eSpark-Backup/griffin-radarsystem-hw/Design Files/MainBoard_2.0/Renderings/2D_C-View.PNG

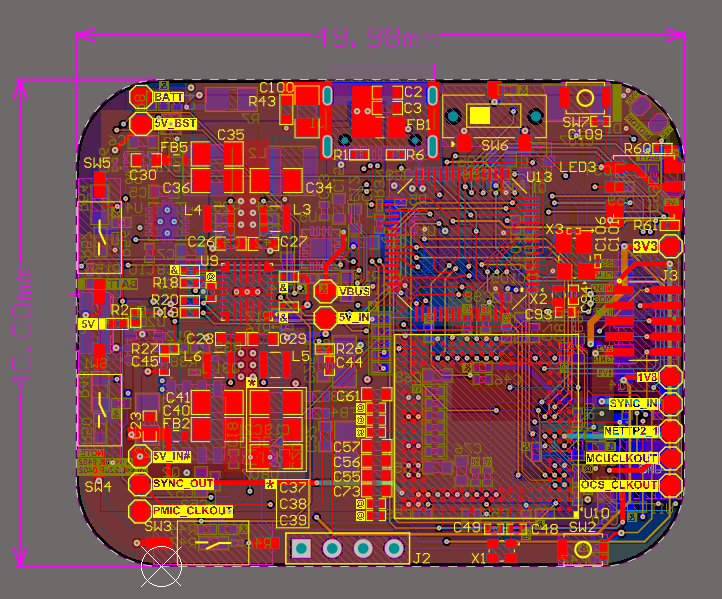
Design Files/MainBoard_2.0/Renderings/2D_C-View.PNG
