eSpark-Backup/griffin-radarsystem-hw/Design Files/MainBoard_2.0/Renderings/2D_Top-Layer.PNG

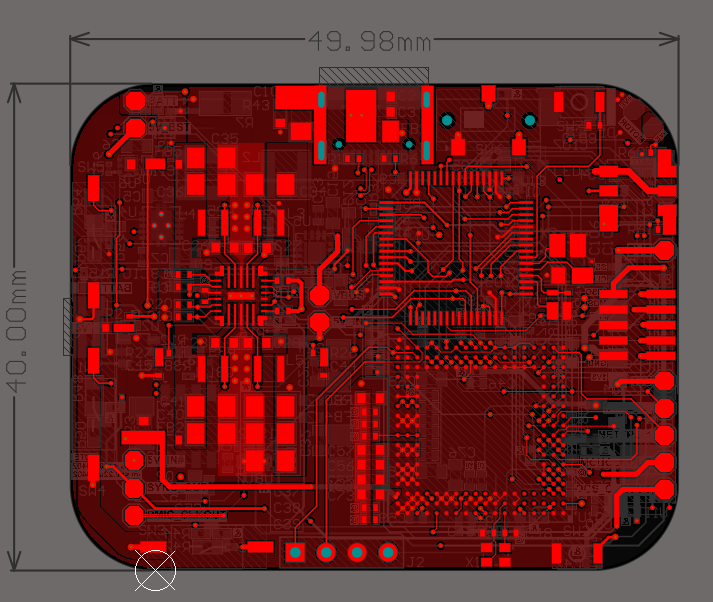
Design Files/MainBoard_2.0/Renderings/2D_Top-Layer.PNG
