eSpark-Backup/griffin-radarsystem-hw/Design Files/MainBoard_2.0/Renderings/3D_Top-View.PNG

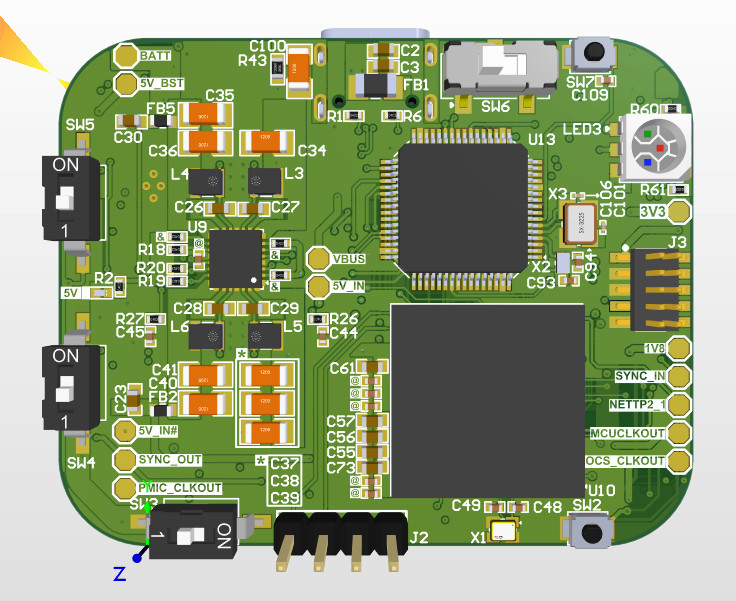
Design Files/MainBoard_2.0/Renderings/3D_Top-View.PNG
