eSpark-Backup/griffin-radarsystem-hw/Design Files/SecondaryBoard_2.0/Renderings/2D_Bottom_Layer.PNG

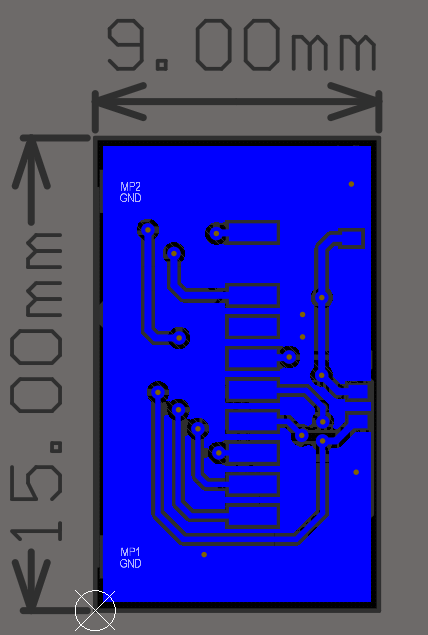
Design Files/SecondaryBoard_2.0/Renderings/2D_Bottom_Layer.PNG
