eSpark-Backup/griffin-radarsystem-hw/Design Files/MainBoard_2.0/BOM/Client-BOM-Main_Board_2.0.xlsx

# | Item Type | Designator | Description | Footprint | Manufacturer Part Number | Manufacturer | Value | Quantity | Remarks
1 | Capacitor | C1, C46, C47, C51, C53, C79, C80, C96, C97, C98, C99, C104, C105, C107, C109 | CAP CER 0.1UF 16V X7R 0402 | Cap-0402 | CC0402JRX7R7BB104 | Yageo | 0.1uF | 15
2 | Capacitor | C2, C3, C14, C23, C25, C26, C27, C28, C29, C30, C32, C52, C54, C57, C61, C65, C69, C73, C76, C90 | CAP CER 10UF 16V X5R 0603 | Cap-0603 | CC0603KRX5R7BB106 | Yageo | 10uF | 20
3 | Capacitor | C4, C11, C18, C19, C20, C21, C50, C58, C60, C102 | CAP CER 1UF 16V X5R 0402 | Cap-0402 | CC0402KRX5R7BB105 | Yageo | 1uF | 10
4 | Capacitor | C5, C7, C8, C9 | CAP CER 22UF 10V X5R 0603 | Cap-0603 | CC0603MRX5R6BB226 | Yageo | 22uF | 4
5 | Capacitor | C6, C12, C15, C17, C55, C56, C81, C87 | CAP CER 2.2UF 25V X5R 0603 | CAP-0603 | CC0603KRX5R8BB225 | Yageo | 2.2uF | 8
6 | Capacitor | C10, C103 | CAP CER 10000PF 25V X7R 0402 | Cap-0402 | CC0402KRX7R8BB103 | Yageo | 10nF | 2
7 | Capacitor | C13, C59 | CAP CER 0.047UF 50V X7R 0402 | Cap-0402 | CC0402KRX7R9BB473 | Yageo | 47nF | 2
8 | Capacitor | C16 | CAP CER 1000PF 25V X5R 0201 | CAP-0201 | CC0201KRX5R8BB102 | Yageo | 1nF | 1
9 | Capacitor | C22, C24, C31, C34, C35, C36, C37, C38, C39, C40, C41 | CAP CER 22UF 25V X5R 1206 | Cap-1206 | C3216X5R1E226M160AB | TDK | 22uF | 11
10 | Capacitor | C33, C62, C63, C64, C66, C67, C68, C70, C71, C72, C74, C75, C77, C78, C82, C83, C84, C85, C86, C88, C89, C91, C92 | CAP CER 0.22UF 25V X5R 0402 | Cap-0402 | CC0402KRX5R8BB224 | Yageo | 0.22uF | 23
11 | Capacitor | C42, C43, C44, C45 | CAP CER 390PF 50V C0G 0402 | Cap-0402 | CGA2B2C0G1H391J050BA | TDK | 390pF | 4
12 | Capacitor | C48, C49 | CAP CER 4.7PF 50V C0G/NPO 0402 | Cap-0402 | CC0402BRNPO9BN4R7 | Yageo | 4.7pF | 2
13 | Capacitor | C93, C94 | CAP CER 19PF 50V C0G/NP0 0402 | Cap-0402 | GJM1555C1H190GB01D | Murata | 19pF | 2
14 | Capacitor | C95 | CAP CER 4.7UF 16V X5R 0603 | Cap-0603 | CC0603KRX5R7BB475 | Yageo | 4.7uF | 1
15 | Capacitor | C100 | CAP CER 4700PF 1KV X7R 1206 | Cap-1206 | CC1206KKX7RCBB472 | Yageo | 4.7nF | 1
16 | Capacitor | C101, C106 | CAP CER 18PF 25V C0G/NP0 0201 | CAP-0201 | GJM0335C1E180GB01D | Murata Electronics | 18pF | 2
17 | Diode | D1 | 1A Single 50V 1.1V@1A SMA(DO-214AC) Diodes - General Purpose ROHS | SMA(DO-214AC) | 1N4001 | TWGMC | 1N4001 | 1
18 | Ferrite Bead | FB1 | FERRITE BEAD 120 OHM 1206 1LN | IND-1206 | BLM31PG121SN1L | Murata | 100MHz | 1
19 | Ferrite Bead | FB2, FB3, FB4, FB5 | FERRITE BEAD 100 OHM 0603 1LN | IND-0603 (1608 Metric) | BLM18SP101SZ1D | Murata | 100MHz | 4
20 | Connector | J1 | 5A 1 16P Female Type-C SMD USB Connectors ROHS | TYPE-C-31-M-12_ | TYPE-C-31-M-12 | Korean Hroparts Elec | TYPE-C-31-M-12 | 1
21 | Header | J2 | Straight 2.54mm Black Brass 1x4P Plugin,P=2.54mm Pin Headers ROHS | HDR1X4_ | B-2100S04P-A110 | Ckmtw | - | 1
22 | Header | J3 | CONN HEADER SMD 10POS 1.27MM | Custom | 20021121-00010C4LF | Amphenol ICC (FCI) | - | 1
23 | JST Connector | J4 | CONN HEADER SMD R/A 10POS 1MM | SM10B-SRSS-TB(LF)(SN) | SM10B-SRSS-TB(LF)(SN) | JST | - | 1
24 | Inductor | L1, L2 | FIXED IND 1UH 5.8A 26 MOHM SMD | Custom | WPN4020H1R0MT | Sunlord | 1uH | 2
25 | Inductor | L3, L4, L5, L6 | FIXED IND 470NH 4A 0.027OHM SMD | IND-1008 (2520 Metric) | DFE252012PD-R47M=P2 | Murata | 470nH | 4
26 | LED | LED1 | LED GREEN CLEAR CHIP SMD | LED-0402 | XZVG68W-2 | SunLED | - | 1
27 | LED | LED2 | LED RED CLEAR CHIP SMD | LED-0402 | XZMDK68W-2 | SunLED | - | 1
28 | RGB LED | LED3 | 20mA White Diffused -40℃~+85℃ RGB SMD5050 Light Emitting Diodes (LED) ROHS | SMD5050 | MHP5050RGBDT | MEIHUA | - | 1
29 | Mosfet | Q1 | TRANS NPN 40V 0.6A SMD SOT23-3 | SOT-23 | MMBT2222A-7-F | Diodes | - | 1
30 | MOSFET | Q2 | MOSFET P-CH 12V 16A 8SO | SOP-8 | IRF7410TRPBF | Infineon | - | 1
31 | Mosfet | Q3 | 40V 100mW 100@10mA,1V 200mA 300MHz 300mV@50mA,5mA NPN -55℃~+150℃@(Tj) SOT-723 Bipolar Transistors - BJT ROHS | SOT-723 | MMBT3904M | TECH PUBLIC | - | 1
32 | Resistor | R1, R6, R8 | RES 5.1K OHM 1% 1/16W 0402 | Res-0402 | RC0402FR-075K1L | Yageo | 5.1K | 3
33 | Resistor | R2 | RES SMD 510 OHM 1% 1/16W 0402 | Res-0402 | RT0402FRE07510RL | Yageo | 510R | 1
34 | Resistor | R3, R5, R11, R15, R16, R38 | RES 1K OHM 1% 1/20W 0201 | Res-0201 | RC0201FR-071KL | Yageo | 1K | 6
35 | Resistor | R4, R9, R10, R14, R21, R22, R23, R28, R29, R30, R31, R32, R33, R34, R35, R36, R37, R40, R41, R42, R45, R49, R55, R58 | RES 10K OHM 1% 1/16W 0402 | Res-0402 | RC0402FR-0710KL | Yageo | 10K | 24
36 | Resistors | R7 | RES 0.01 OHM 1% 1W 1206 | Res-1206 | PA1206FRE470R01Z | Yageo | 10mR | 1
37 | Resistor | R12, R18, R19, R20, R39 | RES 4.7K OHM 1% 1/16W 0402 | Res-0402 | RC0402FR-074K7L | Yageo | 4.7K | 5
38 | Resistor | R13 | RES 20K OHM 1% 1/10W 0603 | Res-0603 | RC0603FR-0720KL | Yageo | 20K | 1
39 | Resistor | R17 | RES 1.96K OHM 1% 1/10W 0603 | Res-0603 | RC0603FR-071K96L | Yageo | 1.96K | 1
40 | Resistors | R24, R25, R26, R27 | RES SMD 3.83 OHM 1% 1/16W 0402 | Res-0402 | CRCW04023R83FKED | Vishay Dale | 3.83R | 4
41 | Resistor | R43 | RES SMD 1M OHM 1% 1/10W 0603 | Res-0603 | RC0603FR-071ML | Yageo | 1M | 1
42 | Resistors | R44 | RES 0 OHM JUMPER 1/16W 0402 | Res-0402 | RC0402FR-070RL | Yageo | 0R | 1
43 | Resistor | R46, R56 | 50mW Thick Film Resistors ±1% 7.87kΩ 0201 Chip Resistor - Surface Mount ROHS | Res-0201 | 0201WMF7871TEE | UNI-ROYAL(Uniroyal Elec) | 7.87k | 2
44 | Resistor | R47, R50, R57 | 82kΩ 0603 Chip Resistor - Surface Mount ROHS | Res-0603 | 0603WAD8202T5E | UNI-ROYAL | 82K | 3
45 | Resistor | R48, R54 | RES SMD 750 OHM 0.1% 1/8W 0805 | RES-0805 | RT0805BRD07750RL | Yageo | 750R | 2
46 | Resistor | R59, R61 | Res 80.6 Ohm 1% 1/16W 0402 | Res-0402 | RN73H1ETTP80R6F50 | KOA Speer | 80.6R | 2
47 | Resistor | R60 | RES 280 OHM 0.5% 1/16W 0402 | Res-0402 | RN73H1ETTP2800D50 | KOA Speer | 280R | 1
48 | Tactile Switch | SW1 | SWITCH TACTILE SPST-NO 0.05A 12V | Custom | EVQ-P7A01P | Panasonic | - | 1
49 | Switch | SW2, SW7 | SWITCH TACTILE SPST-NO 0.05A 12V | Custom | B3U-1000P | Omron | - | 2
50 | Switch | SW3, SW4, SW5 | SPST Black Flat dial, raised type 2.54mm 1 SMD,2.5x6mm DIP Switches ROHS | Custom | DSIC01LSGET | DongGuan | - | 3
51 | Slide Switche | SW6 | SWITCH SLIDE SPDT 200MA 12V | Custom | CL-SB-12B-02T | Nidec Copal | - | 1
52 | IC | U1 | 1.6-V TO 5.5-V, 20-M, 4-A LOW IQ | SOT-583 | TPS2117DRLR | Texas Instruments | - | 1
53 | IC | U2 | IC CNTRLR ON/OFF W/DEB TSOT23-6 | TSOT-23-6 | MAX16054AZT+T | Maxim | - | 1
54 | IC | U3 | IC FUEL GAUGE LI-ION 1CL 9DSBGA | DSBGA-9 (1.651x1.61) | BQ27426YZFR | Texas Instruments | - | 1
55 | IC | U4 | IC REG BOOST 5V 5A 10VSON | 10-VSON (3x3) | TPS61232DRCR | Texas Instruments | - | 1
56 | IC | U5 | IC BATT CHG LI-ION 1CELL 16WQFN | 16-QFN (3x3). | BQ25302RTER | Texas Instruments | - | 1
57 | IC | U6 | Active Low 1 VSOF-5 Monitors & Reset Circuits ROHS | 5-VSOF | BD4830FVE-TR | Rohm | - | 1
58 | IC | U7 | IC REG LINEAR 3.3V 700MA 4XDFN | 4-UDFN (1.0x1.0) | NCP167BMX330TBG | ON Semiconductor | - | 1
59 | IC | U8 | IC REG LINEAR 1.8V 450MA 4XDFN | 4-UDFN (1.0x1.0) | NCP161BMX180TBG | ON Semiconductor | - | 1
60 | IC | U9 | IC REG BUCK ADJ QUAD 26VQFN | 26-VQFN-HR (4.5x4) | LP87524JRNFRQ1 | Texas Instruments | - | 1
61 | IC | U10 | RF IC Transceiver General Purpose 76GHz ~ 81GHz SPI Interface 180-FCBGA (15x15) | 180-FCBGA (15x15) | AWR1843ARBGALPQ1 | Texas Instruments | - | 1
62 | IC | U11 | IC FLASH 16MBIT SPI/QUAD 8WSON | 8-WSON 6x5-mm | MX25V1635FZNQ03 | Macronix | - | 1
63 | IC | U13 | IC MCU 32BIT 256KB FLASH 64LQFP | 64-LQFP (10x10) | STM32L433RCT6 | STMicroelectronics | - | 1
64 | Crystals | X1 | Crystal 40.0000MHZ 8PF SMD | SMD2016-4P | FW4000044Q | Diodes | 40 MHz | 1
65 | Crystal | X2 | CRYSTAL 32.7680KHZ 12.5PF SMD | Custom | ECS-.327-12.5-16-TR | ECS International | 32.768kHz | 1
66 | Crystal | X3 | CRYSTAL 8.0000MHZ 12PF SMD | SMD3225-4P | ECS-80-12-33-JGN-TR | ECS International | 8.0000MHZ | 1
67 | Peripheral | - | JUMPER 10SR-3S - 10SR-3S 4" | Custom | A10SR10SR30K102A | JST Sales America Inc. | - | 1
68 | Peripheral | - | SEGGER 8.08.91 J-Link EDU Mini | Custom | J-Link EDU Mini (8.08.91) | Segger | - | 1
69 | Peripheral | - | CP2102 USB UART Board (Type C), USB To TTL (UART) Communication Module, USB-C Connector | Custom | CP2102 | Waveshare | - | 1
70 | Peripheral | - | 3.7V Lithium polymer 8000mAh 7565121 Soft package battery For Power Bank Bluetooth Speakers Tablet DVD battery | - | Battery | - | - | 1 | Battery (https://vi.aliexpress.com/item/1005004274987553.html?gatewayAdapt=glo2vnm)
