eSpark-Backup/griffin-radarsystem-hw/Design Files/SecondaryBoard_2.0/BOM/Client_BOM_SecondaryBoard_2.0.xlsx

# | Item Type | Designator | Description | Footprint | Manufacturer Part Number | Manufacturer | Value | Quantity | Remarks
1 | Capacitor | C1, C2, C3, C6 | CAP CER 1UF 10V X5R 0402 | Cap-0402 | CC0402KRX5R6BB105 | Yageo | 1uF | 4
2 | Capacitor | C4, C5 | 50V 8pF C0G 0402 Multilayer Ceramic Capacitors MLCC - SMD/SMT ROHS | Cap-0402 | 0402CG8R0C500NT | FH (Guangdong Fenghua Advanced Tech) | 8pF | 2
3 | Ferrite Bead | FB1, FB2 | FERRITE BEAD 120 OHM 0402 1LN | IND-0402 | BLM15PD121SN1D | Murata | - | 2
4 | JST Connector | J1 | CONN HEADER SMD R/A 10POS 1MM | SM10B-SRSS-TB(LF)(SN) | SM10B-SRSS-TB(LF)(SN) | JST | - | 1
5 | IC | U1 | RADAR SENSOR SYSTEM-IN-PACKAGE B | 50-FCCSP (5.2x5.5) | A121-001-T&R | Acconeer | - | 1
6 | Crystal | X1 | CRYSTAL 24.0000MHZ 8PF SMD | SMD2520-4P | ECS-240-8-36-RWN-TR3 | ECS Inc. | - | 1
