eSpark-Backup/griffin-radarsystem-hw/Design Files/MainBoard_2.0/Supporting Files/PCB_Main_Board_v2.0.step

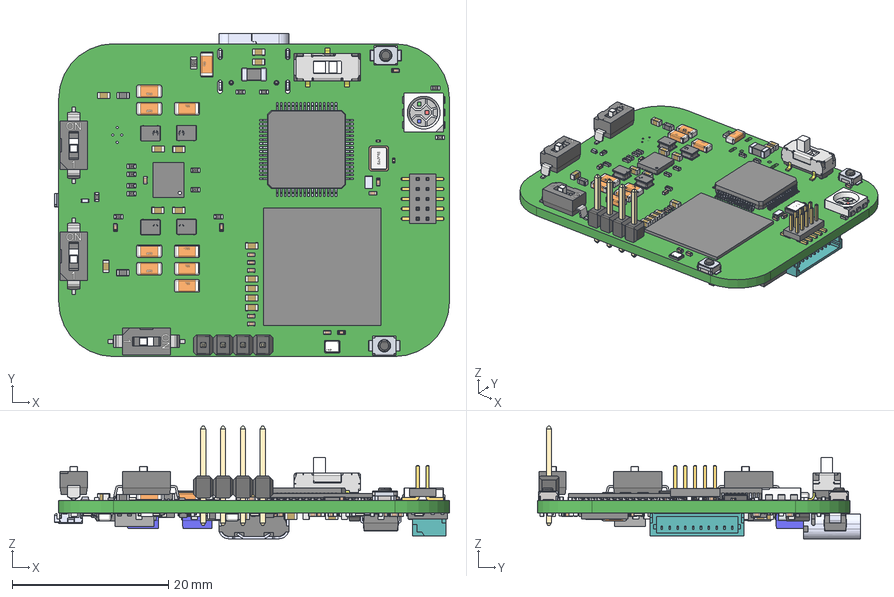
[picture p11: CAD file, 2024-05-08]
Design Files/MainBoard_2.0/Supporting Files/PCB_Main_Board_v2.0.step
50.5 x 41.3 x 14.4 mm
STM32F103RCT7
AWR1843ARBGALPQ1
SMA_(DO-214AC)
User_Library-Capacitor_0402 x 60
User_Library-RES_1005-0402 x 41
User_Library-RESC1608X05N x 6
User_Library-1206_SMD_Capacitor x 12
User_Library-0201(0603M)_Res x 8
VESM
TRANS_IRF7103TRPBF_INF
LED_SMD_5050_RGB
User_Library-CAPC1608X09 x 33
WSON8-6x5
LP87524JRNFRQ1
QFN-16_3X3_MNS
TPS63000DRCR
VLS252012HBX-100M x 4
User_Library-User_Library-Siward_SX3225
ECS-.327-12.5-16-TR--3DModel-STEP-1
Open_CASCADE_STEP_translator_6.8_10.1
Open_CASCADE_STEP_translator_6.8_10.2.1
lead x 5
BQ27426YZFR
User_Library-TSOT-23-6(S6)
User_Library-OMRON_B3U1000P x 2
12B-02_c
2Top_setting_s
SMD_DIP_SWITCH_1P x 3
User_Library-CR2012-0805 x 2
User_Library-CR3216-1206
CircuitWorks-SOT-23
User_Library-LED-0402 x 2
FilletPin1 x 2
FilletPin2 x 2
Conn_JST_SM10B-SRSS-TB_LF_SN_eec
User_Library-RM127_10pin_Header
holder
pin x 4
Lötende x 8
base x 4
BLM31PG121SN1L
User_Library-SMD_Ceramic_Capacitors_0201_(0603)_AB x 3
TYPE-C-31-M-12
EVQ-P7A01P--3DModel-STEP-269445
