eSpark-Backup/griffin-radarsystem-hw/Design Files/SecondaryBoard_2.0/Supporting Files/SecondaryBoard_2.0.step

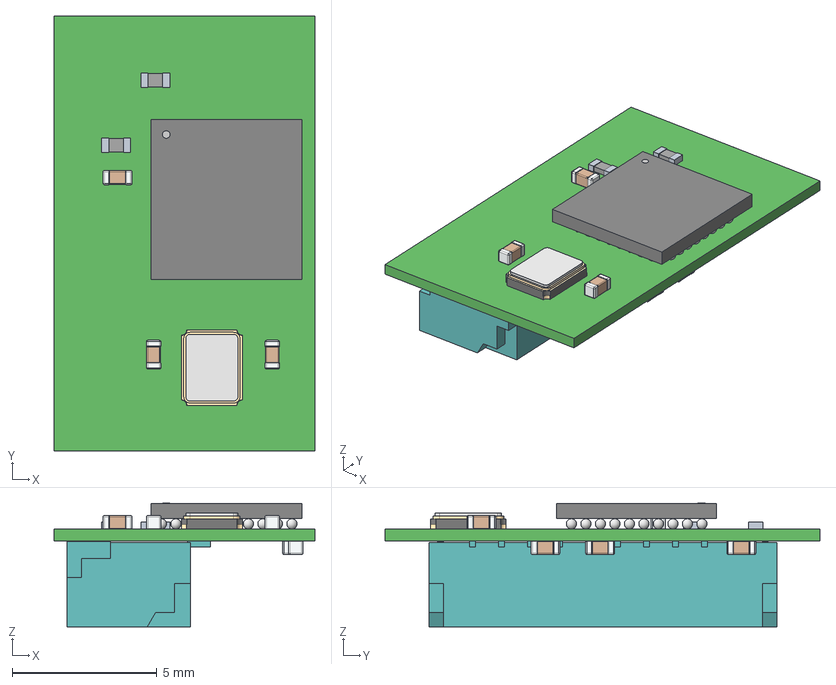
[picture p12: CAD file, 2024-05-08]
Design Files/SecondaryBoard_2.0/Supporting Files/SecondaryBoard_2.0.step
9.00 x 15.0 x 4.26 mm
User_Library-Capacitor_0402 x 6
User_Library-Crystal_NDK_NX2520SA_series
A111_ACC
Conn_JST_SM10B-SRSS-TB_LF_SN_eec
User_Library-d0402h025 x 2
