eSpark-Backup/griffin-radarsystem-hw/docs/Client-Files/Src Files - v1.0/60ghz radar 2nd pcb/2nd pcb.DXF

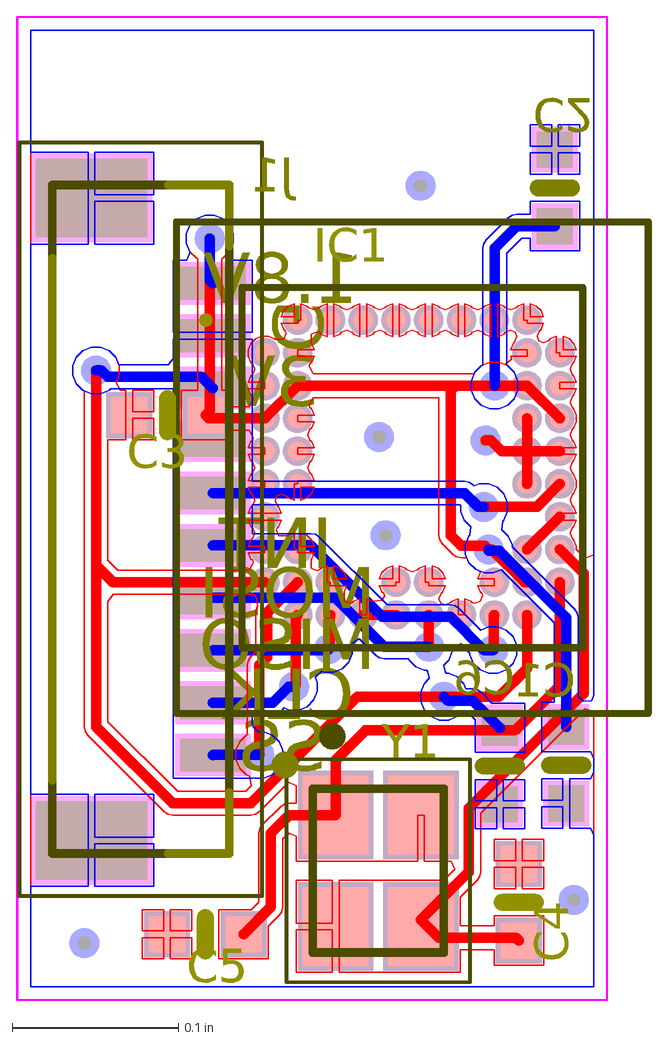
[picture p13: CAD file, 2024-05-08]
docs/Client-Files/Src Files - v1.0/60ghz radar 2nd pcb/2nd pcb.DXF
G
3V
1.8V
MISO
MOSI
INT
CLK
SS
Y1
J1
IC1
C3
C5
C4
C1
C6
C2
