eSpark-Backup/griffin-radarsystem-hw/(list of files, cad)

Other CAD files:
Design Files/MainBoard_2.0/Supporting Files/PCB_Main_Board_v2.0.DWG
Design Files/MainBoard_2.0/Supporting Files/PCB_Main_Board_v2.0.DXF
Design Files/SecondaryBoard_2.0/Supporting Files/SecondaryBoard_2.0.DWG
Design Files/SecondaryBoard_2.0/Supporting Files/SecondaryBoard_2.0.DXF
