eSpark-Backup/griffin-radarsystem-hw/Design Files/MainBoard_2.0/Schematic/Schematic_Main_Board_2.0.pdf

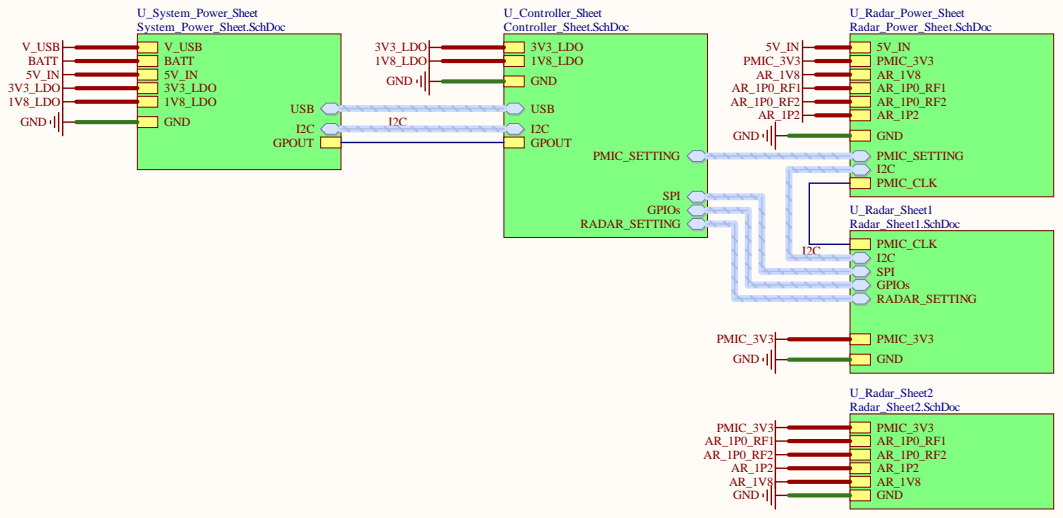
[picture p14: page 1]

Cannot open file
D:\eSpark-Consultants\eSpark-Hardware\Altium
Template\espark-consulting-group-800x300.jpg.
File does not exist.

Date: 5/8/2024 | Page Num: 1

Drawn By: Huzaifa Ali | Page Total:

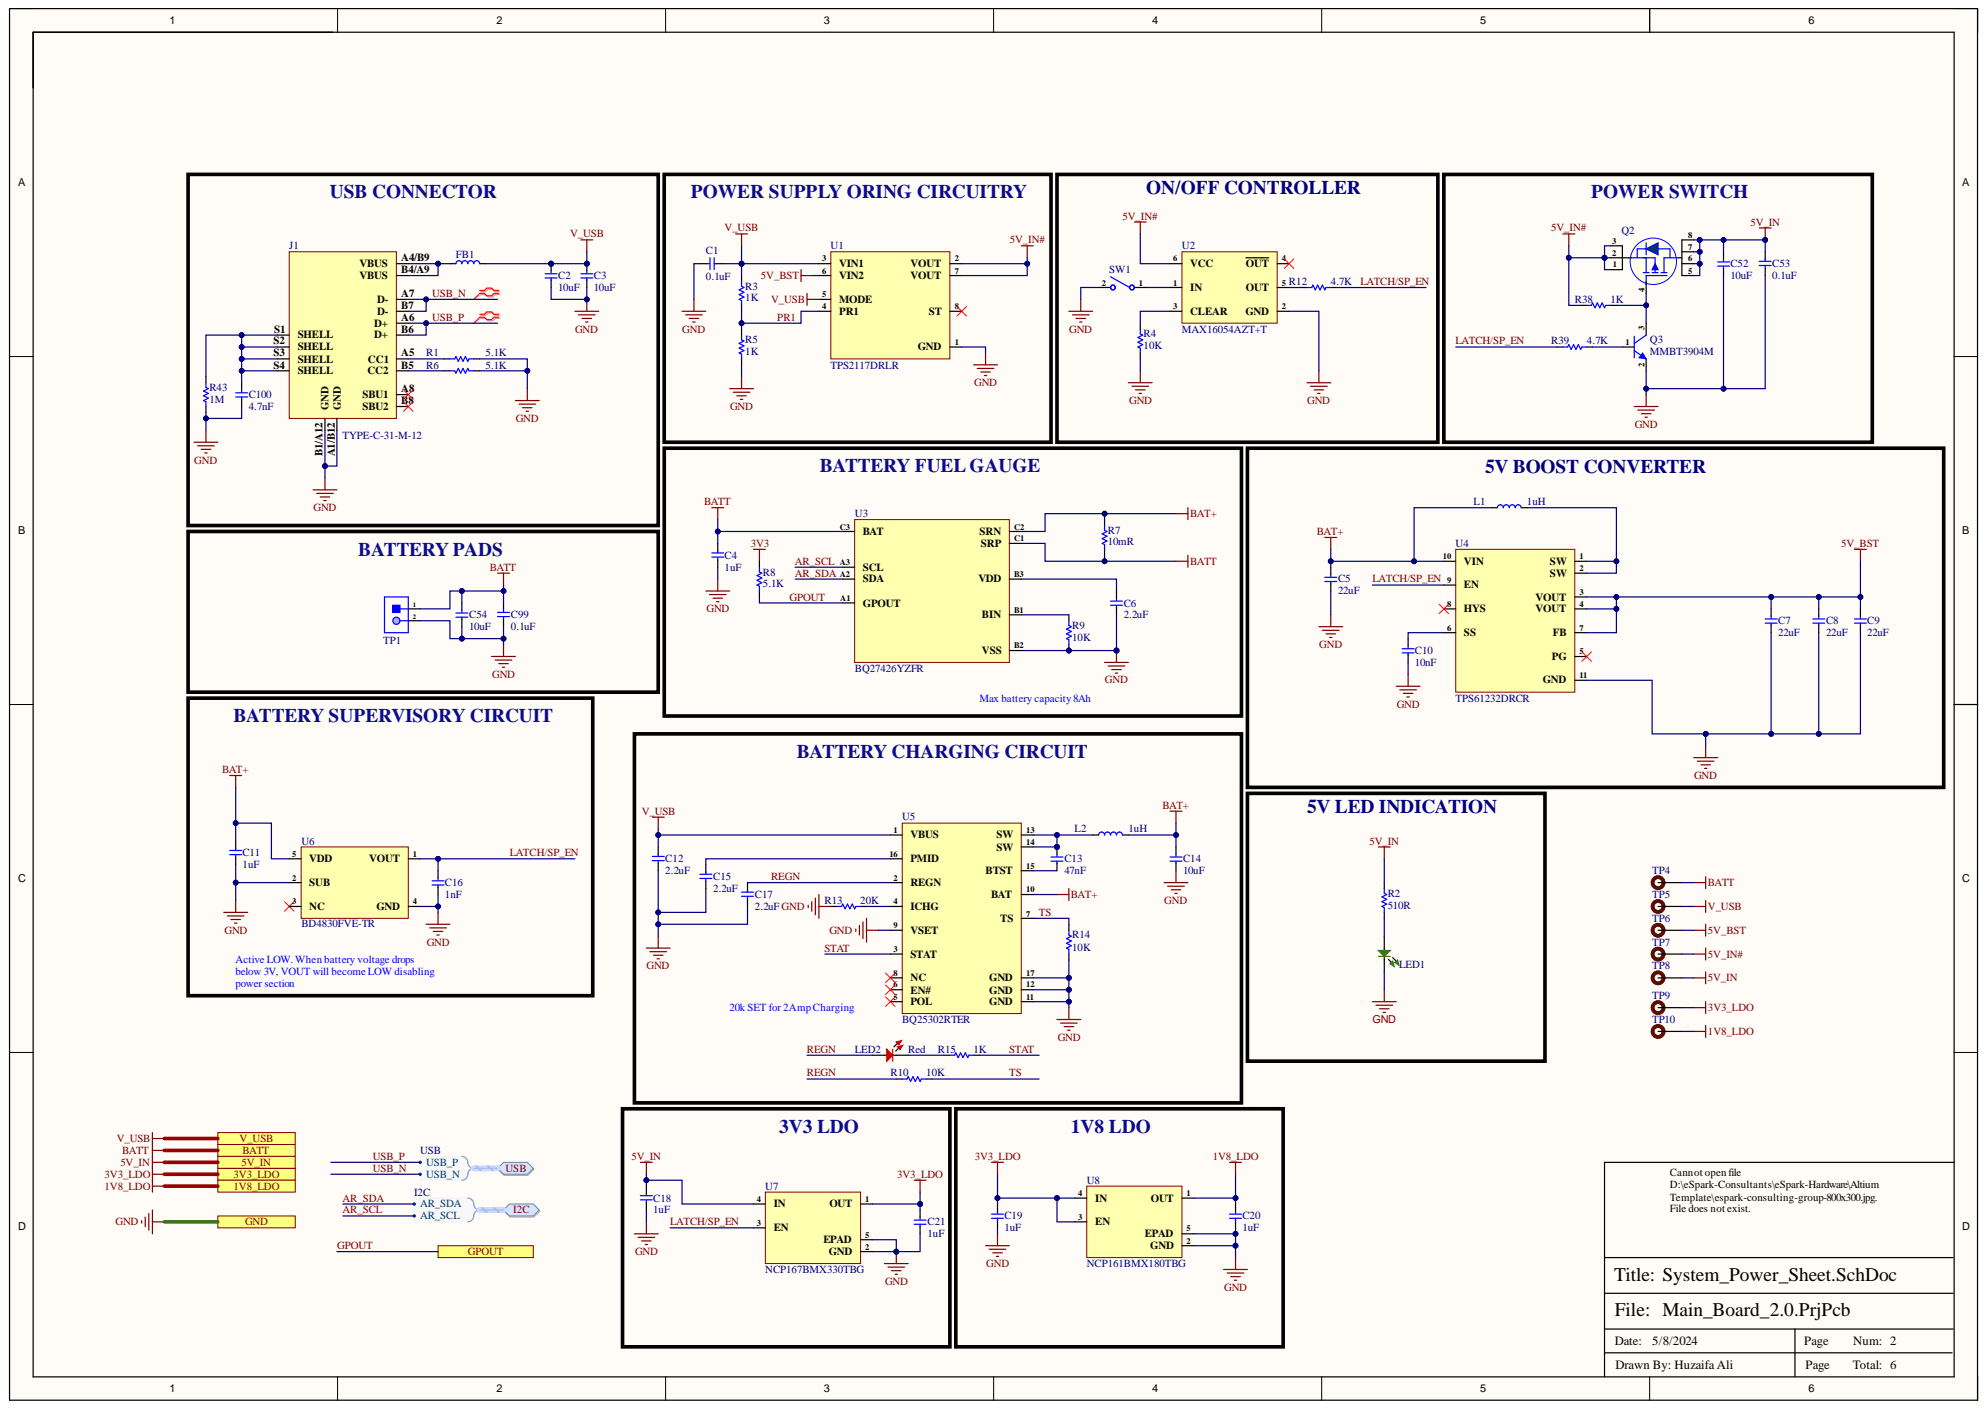
[picture p15: page 2]

Active LOW. When battery voltage drops
below 3V, VOUT will become LOW disabling
power section

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

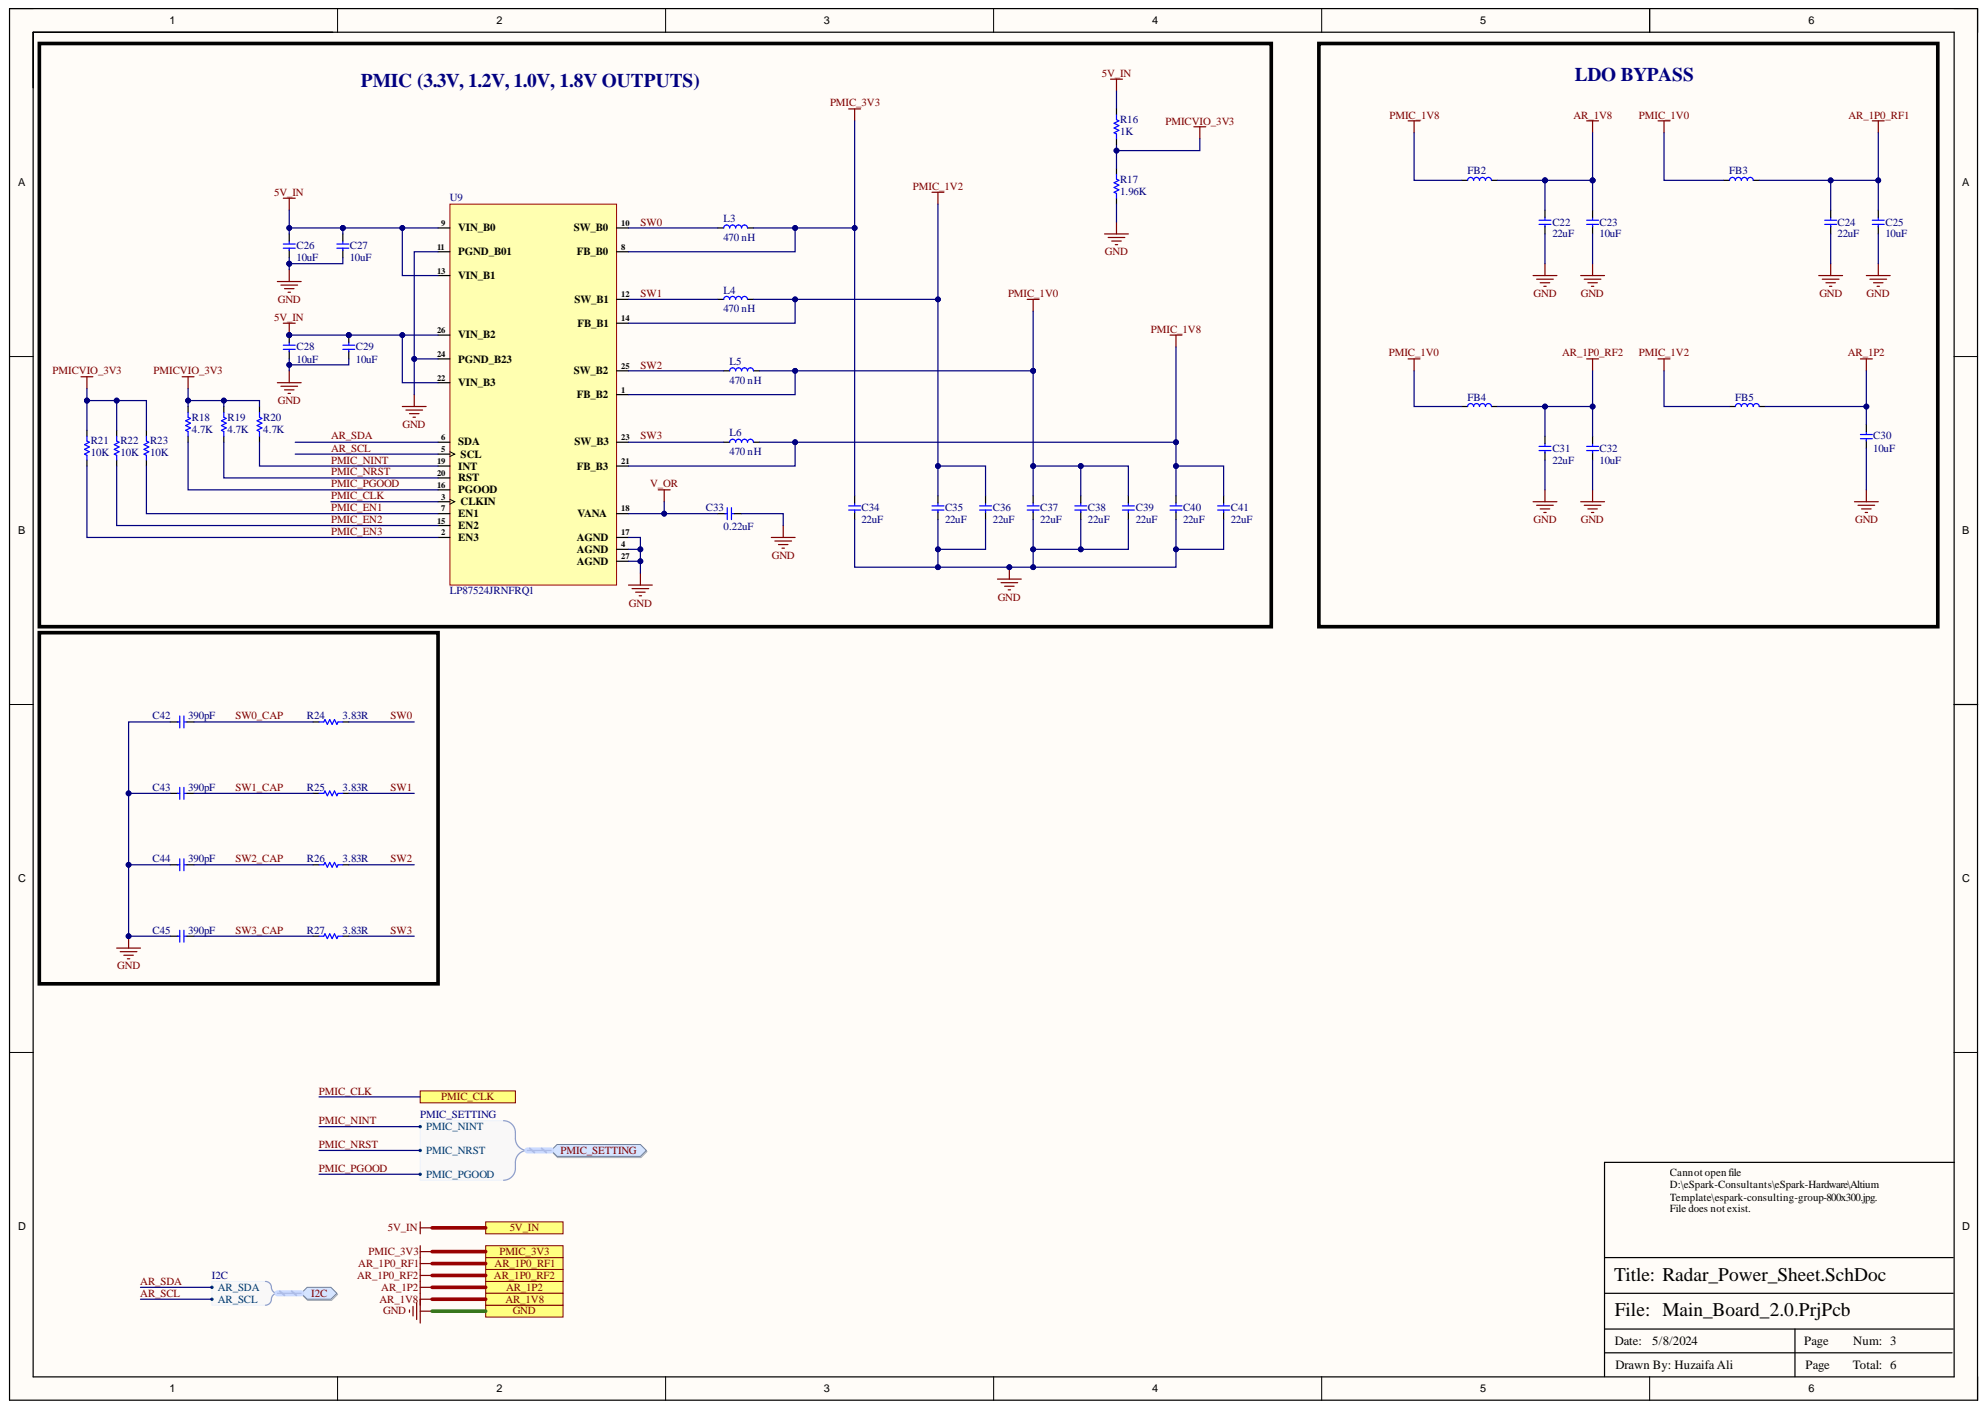
[picture p16: page 3]

L5 SW2
470 nH | GND

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

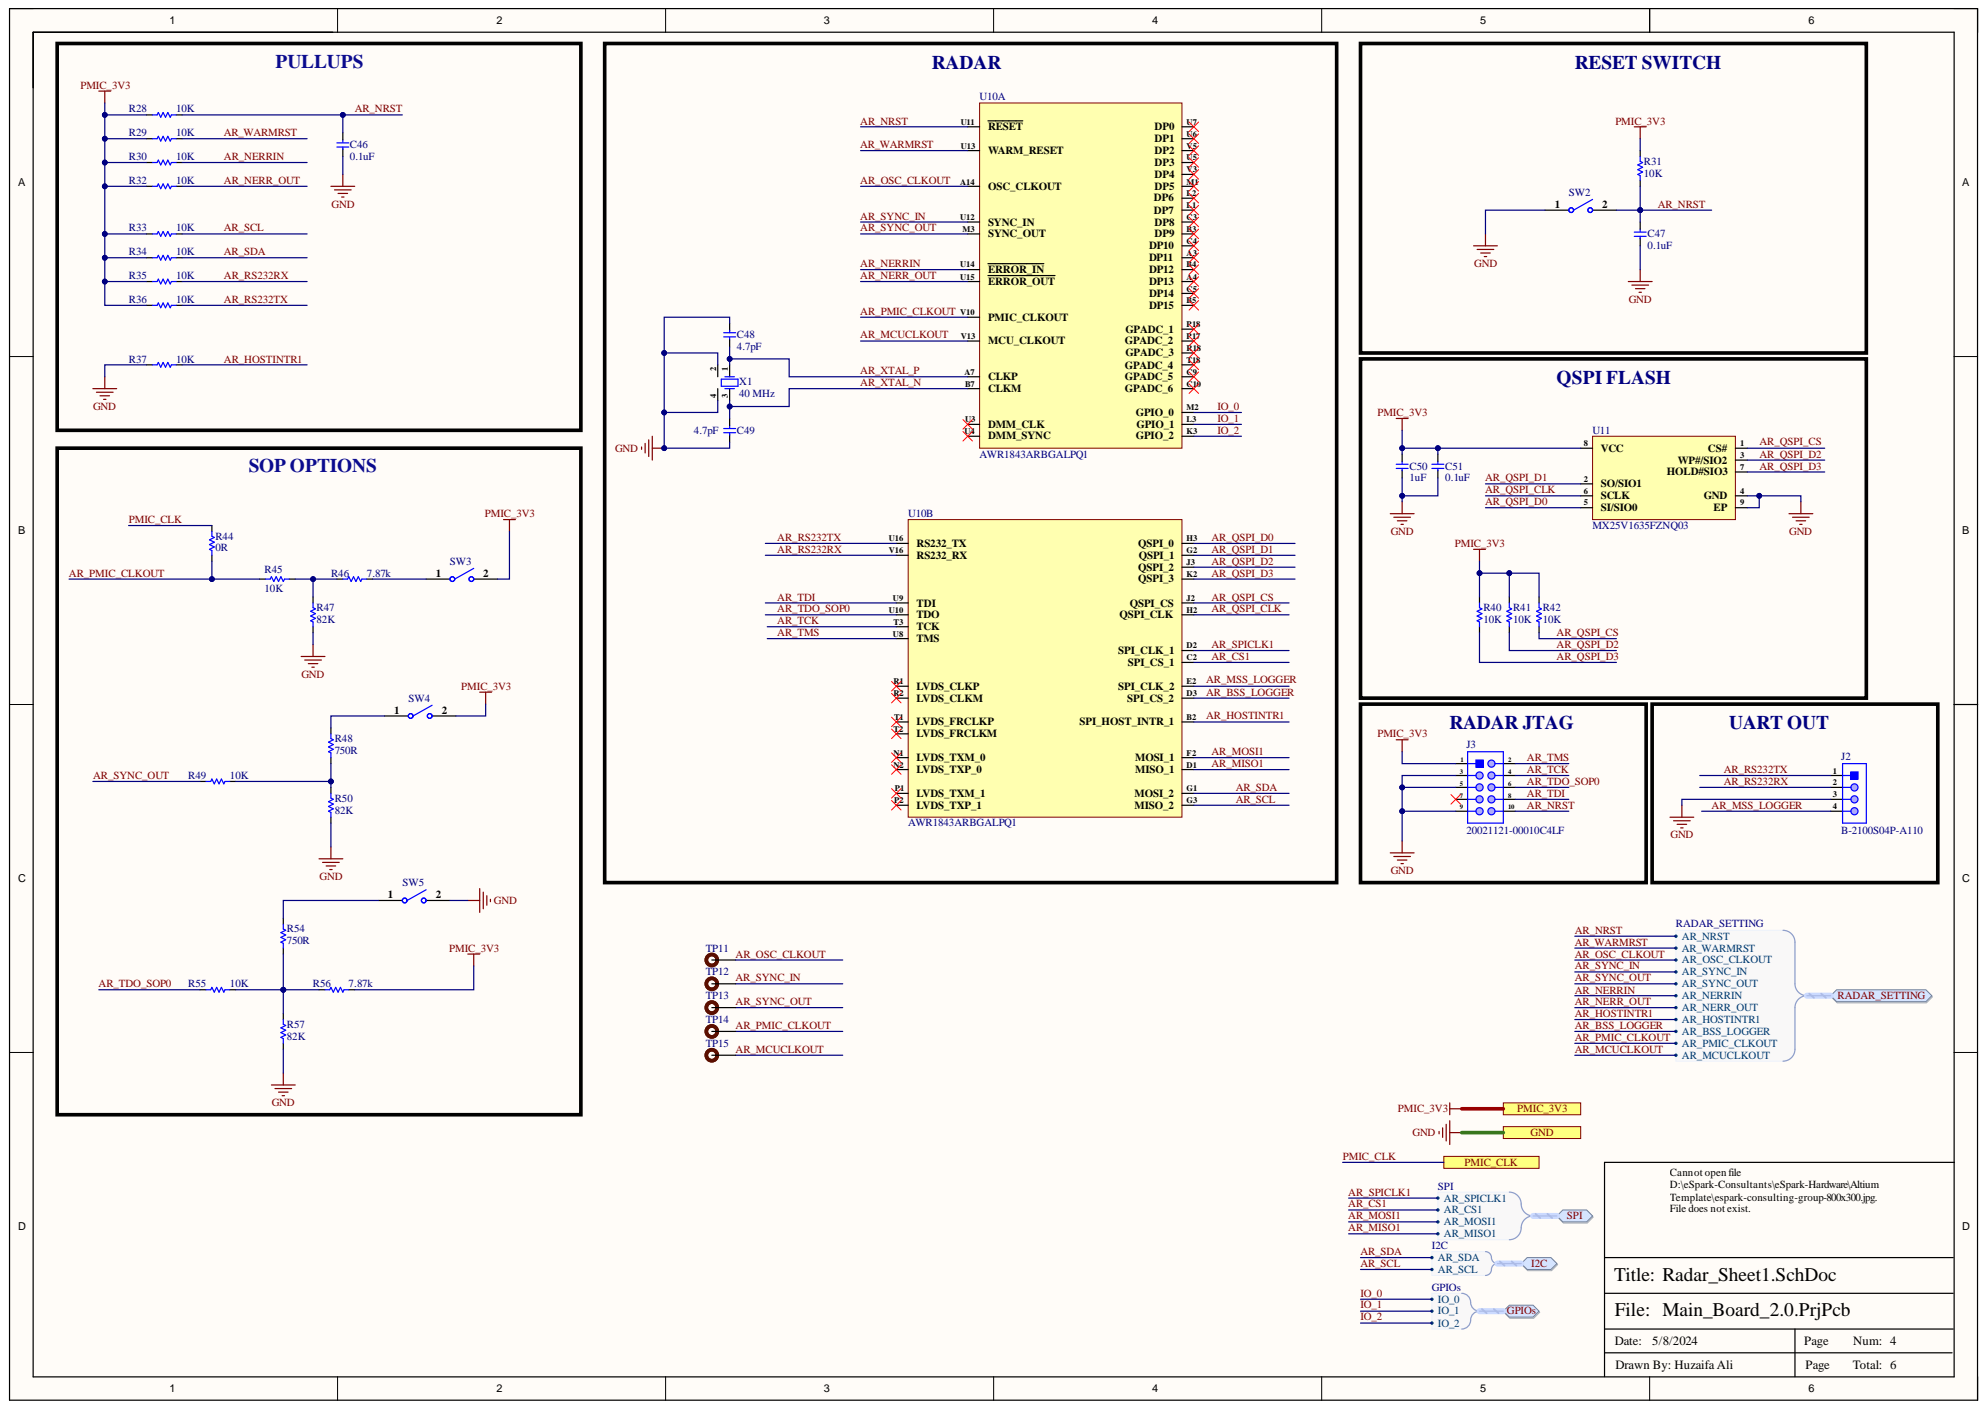
[picture p17: page 4]

AR_QSPI_CS

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

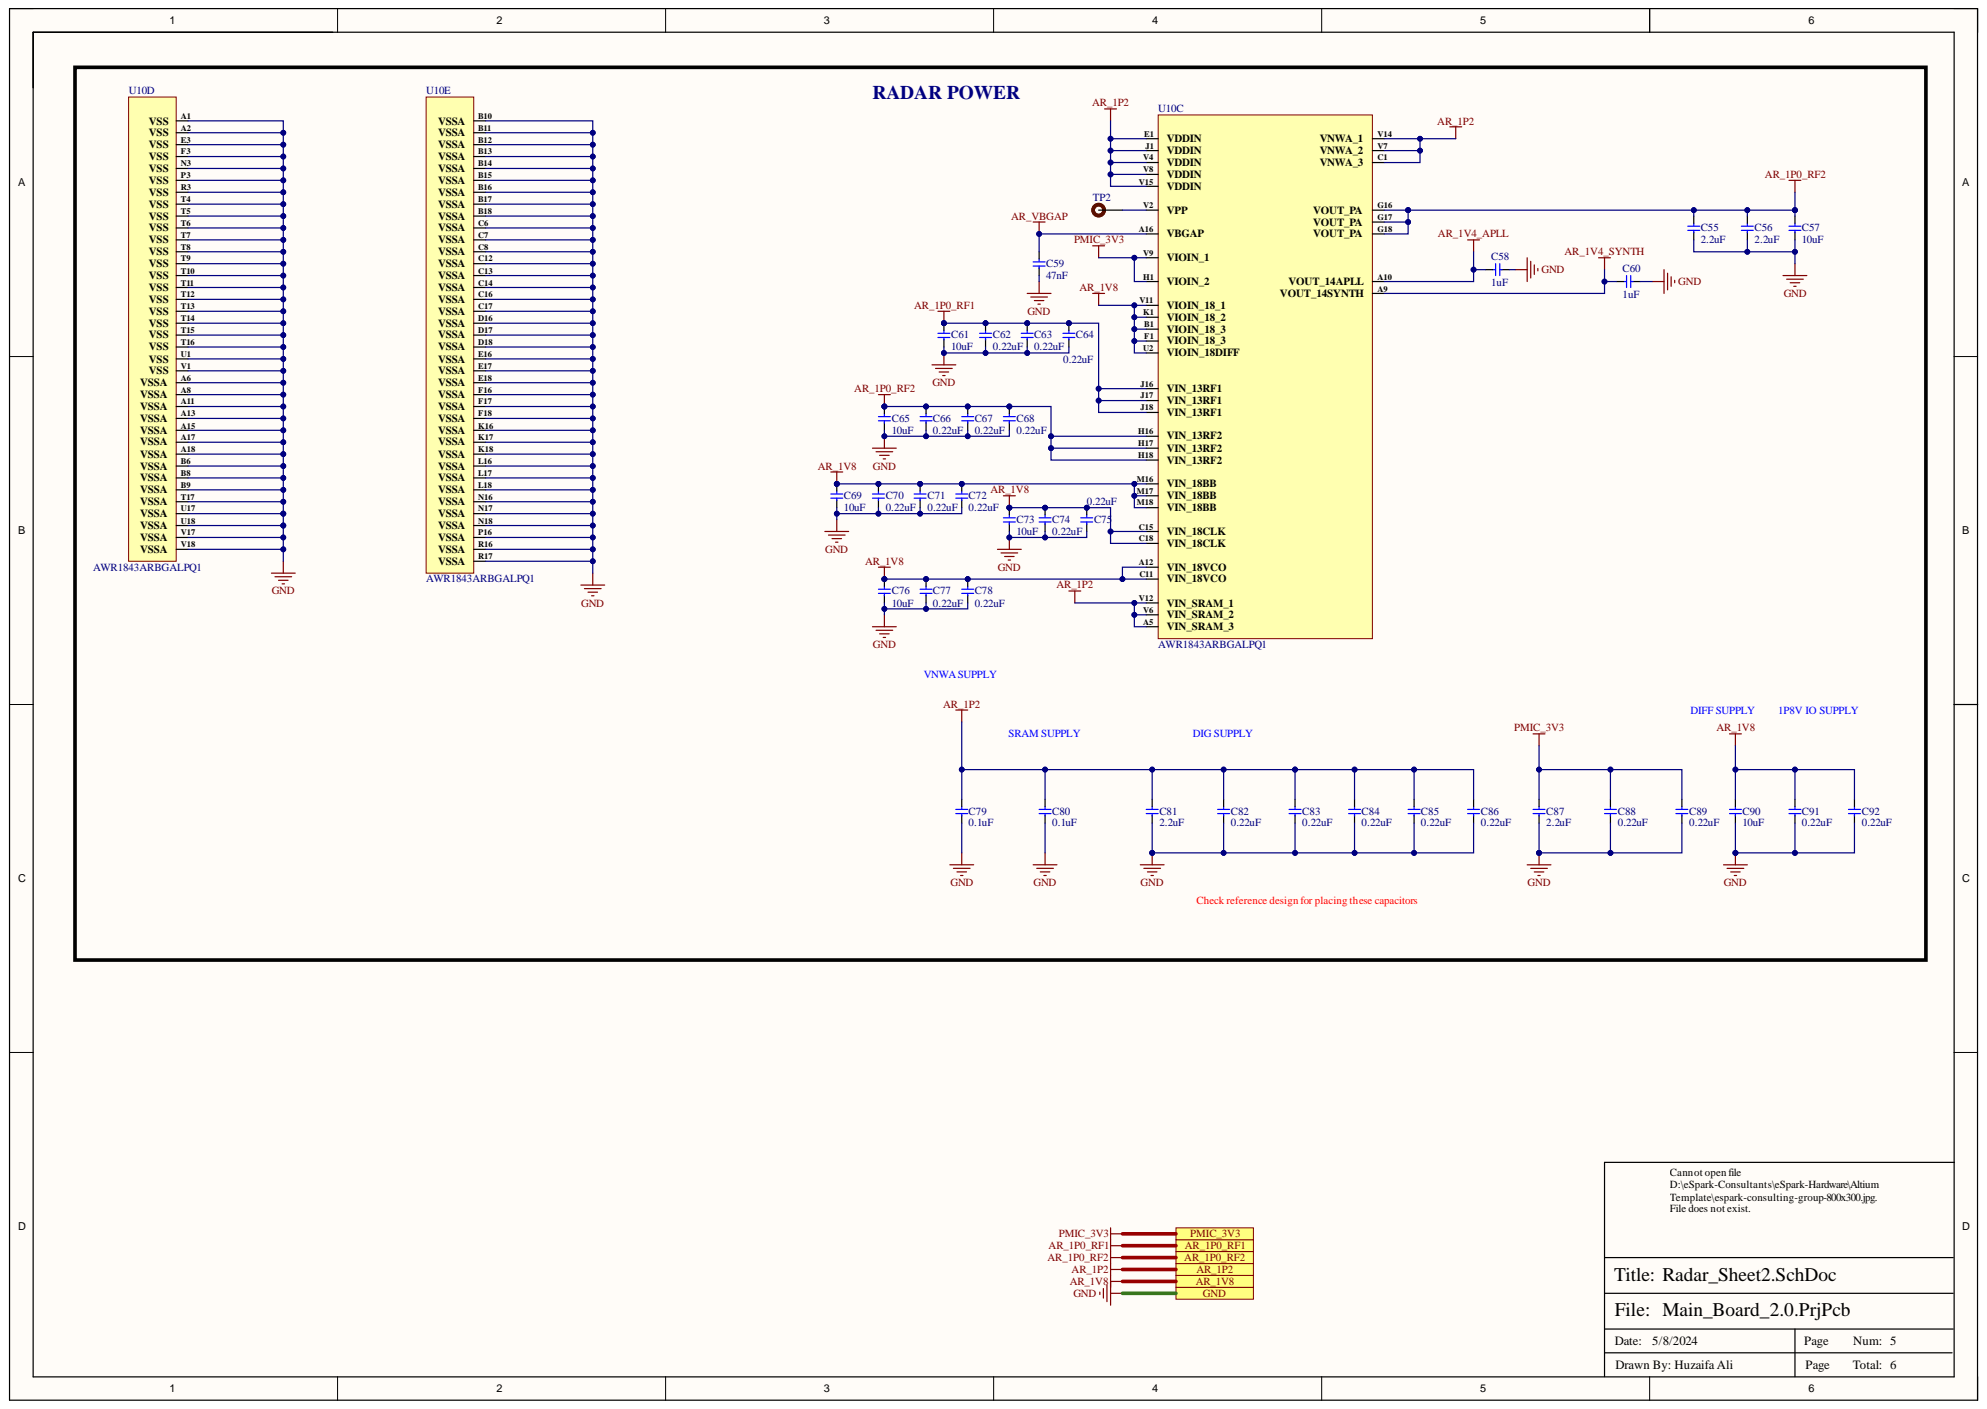
[picture p18: page 5]

C55 C56 AR_1V4_APLL

PMIC_3V3 | VIOIN_1 V9

Check reference design for placing these capacitors

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

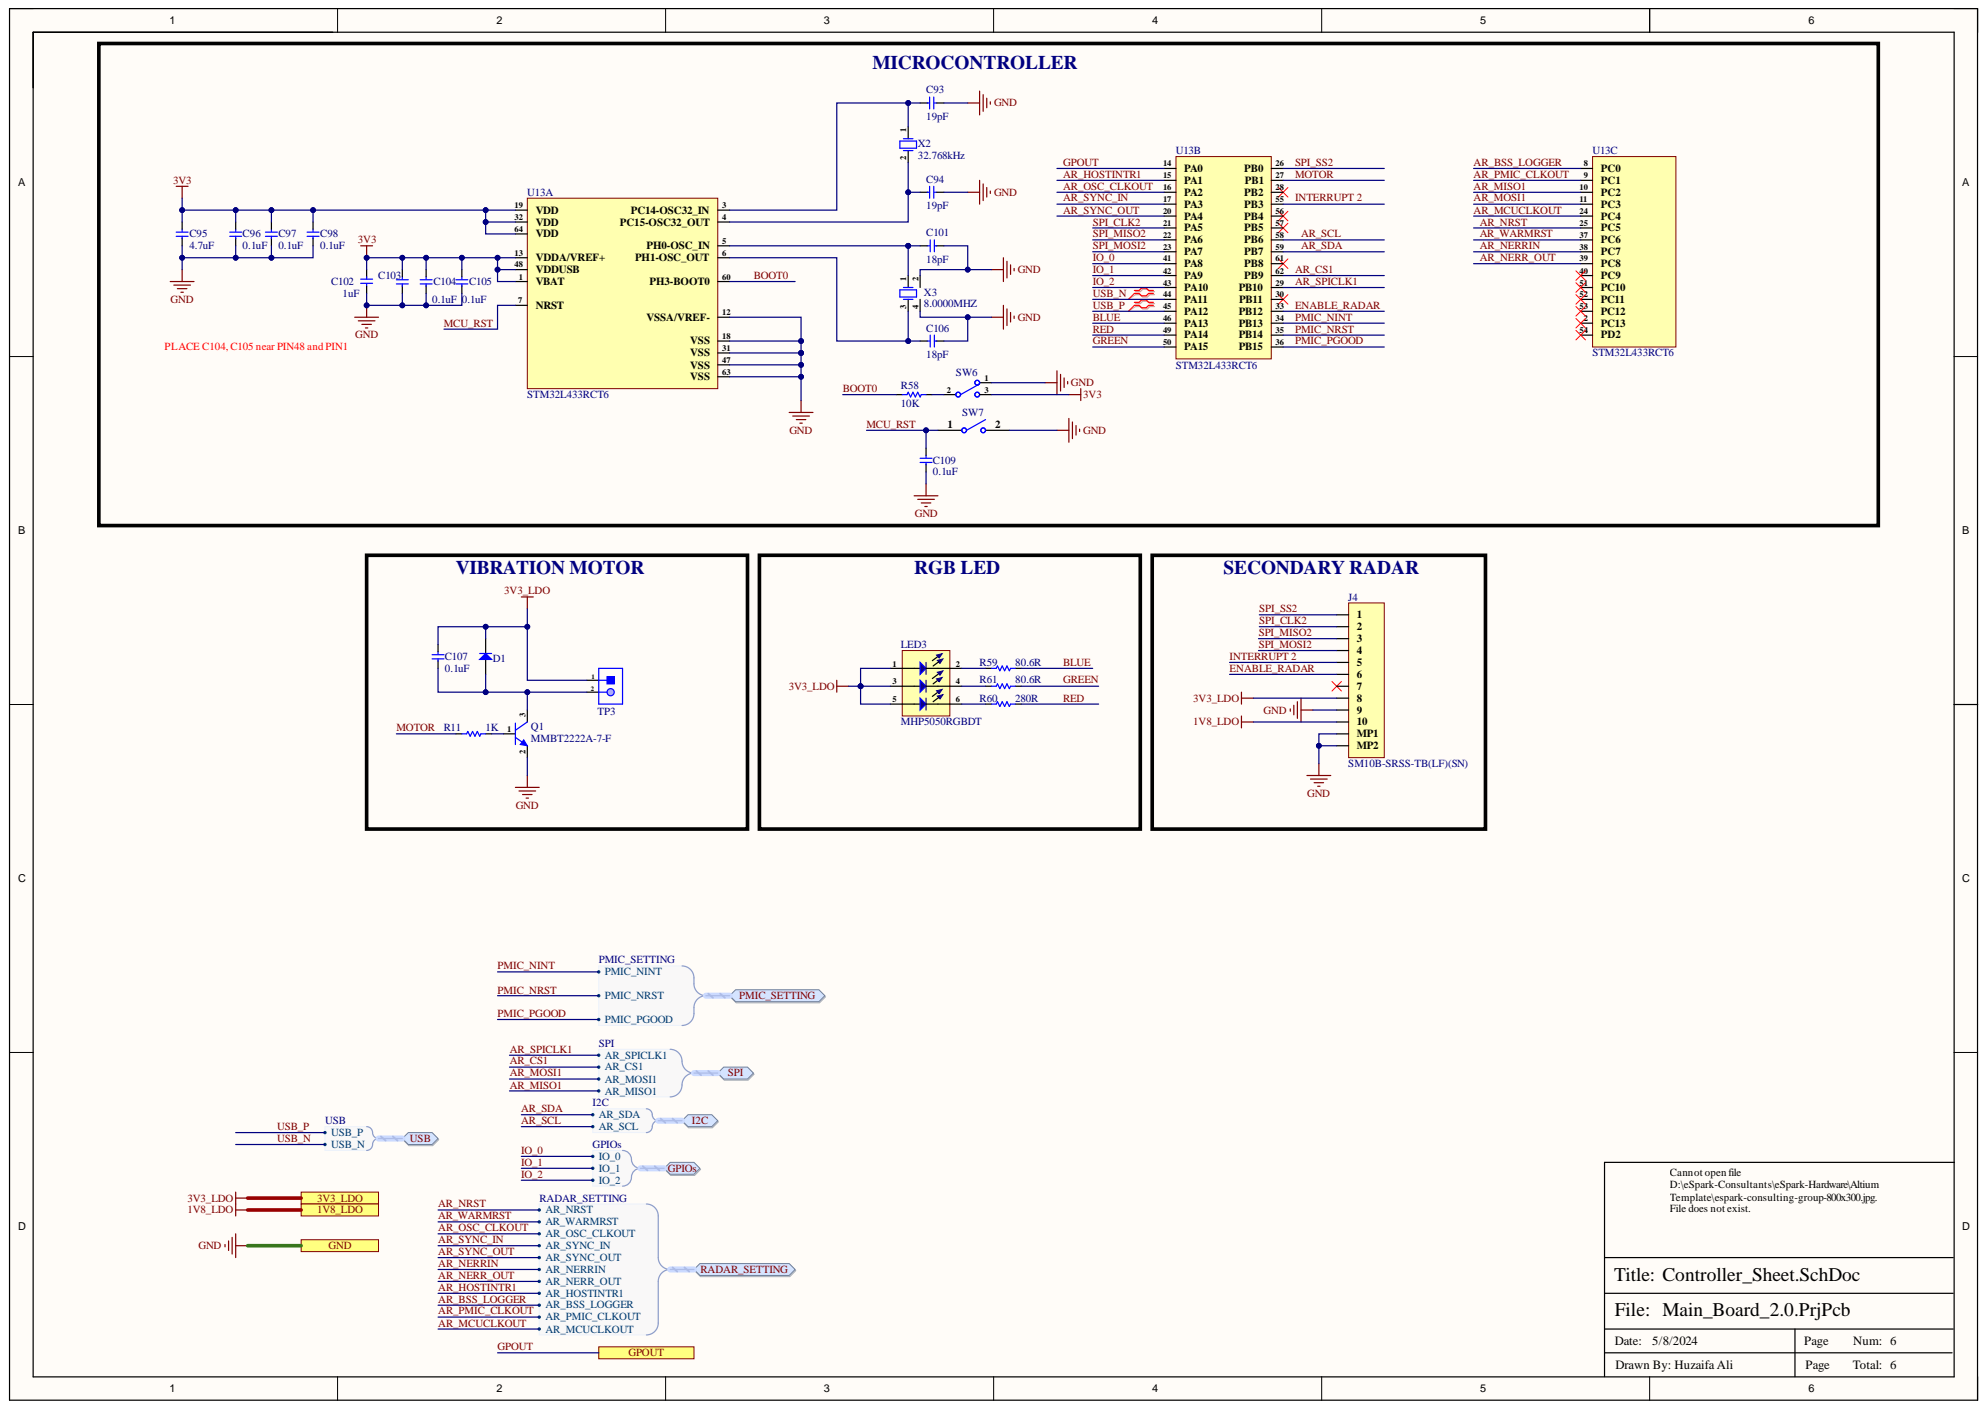
[picture p19: page 6]
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
