eSpark-Backup/griffin-radarsystem-hw/Design Files/MainBoard_2.0/Schematic/Assembly_Drawings.pdf

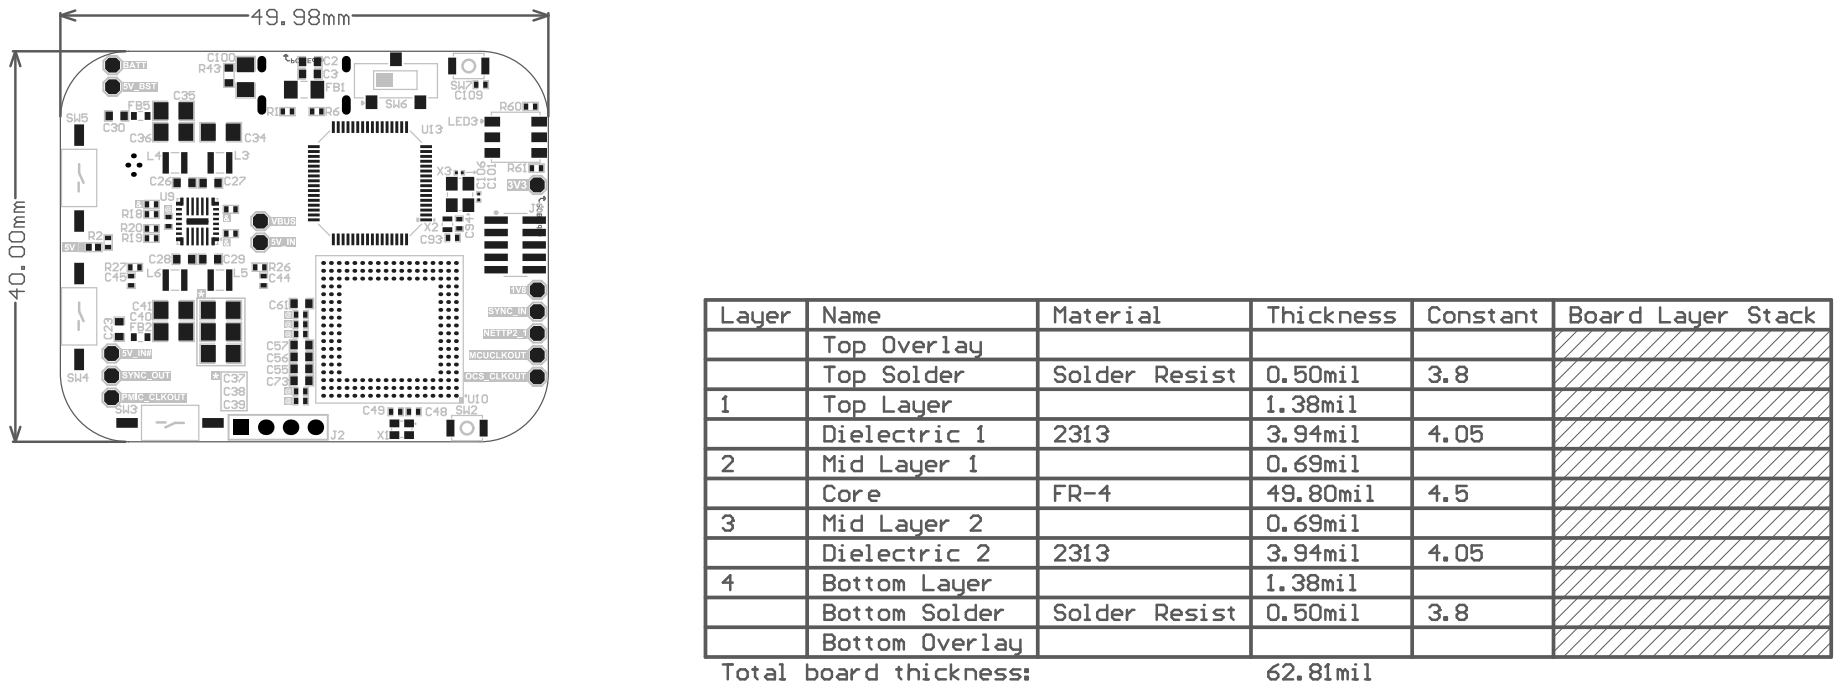
[picture p20: page 1]

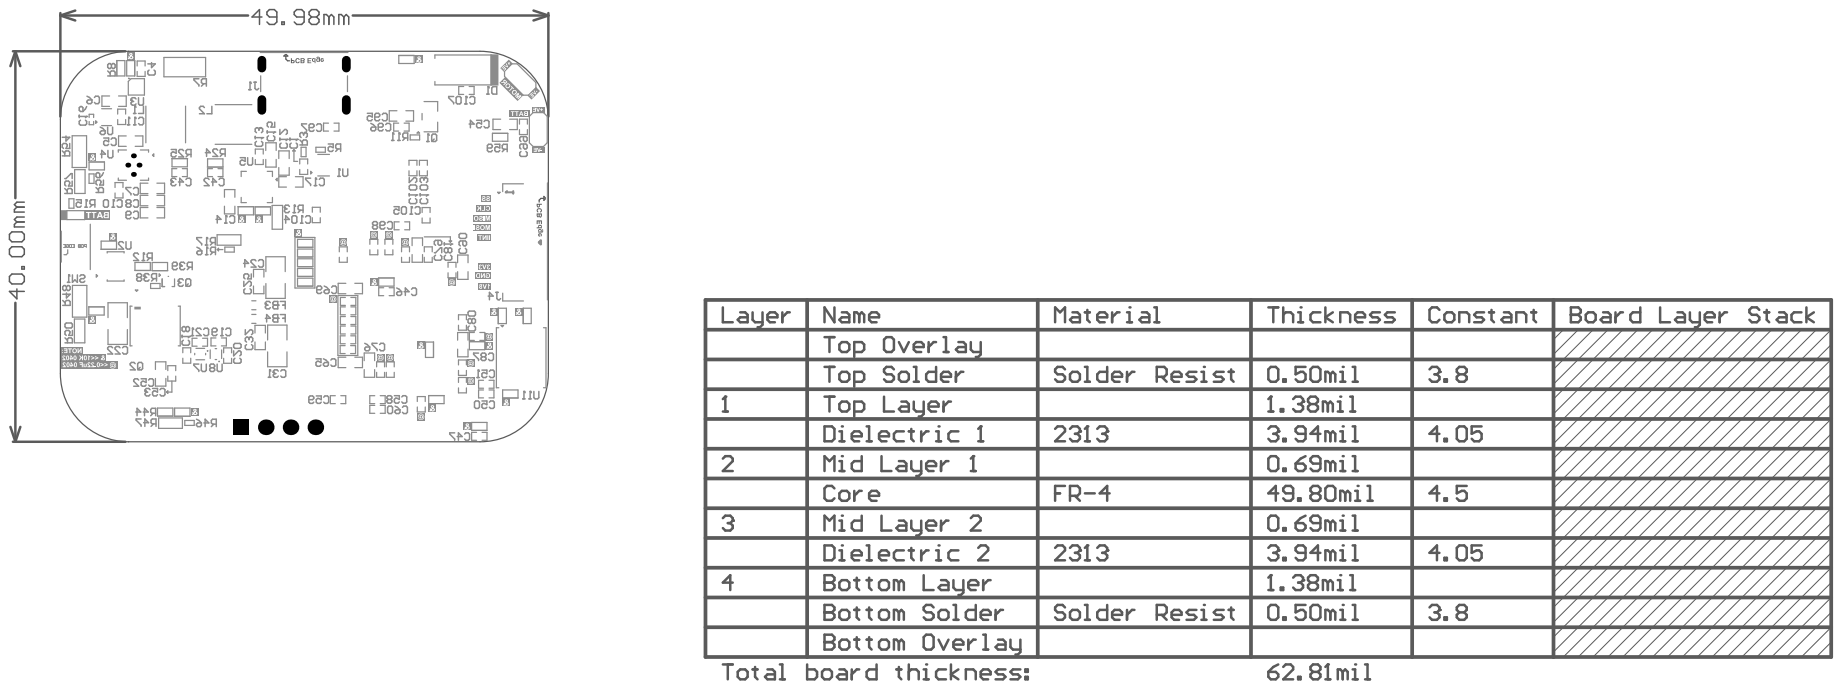
[picture p21: page 2]

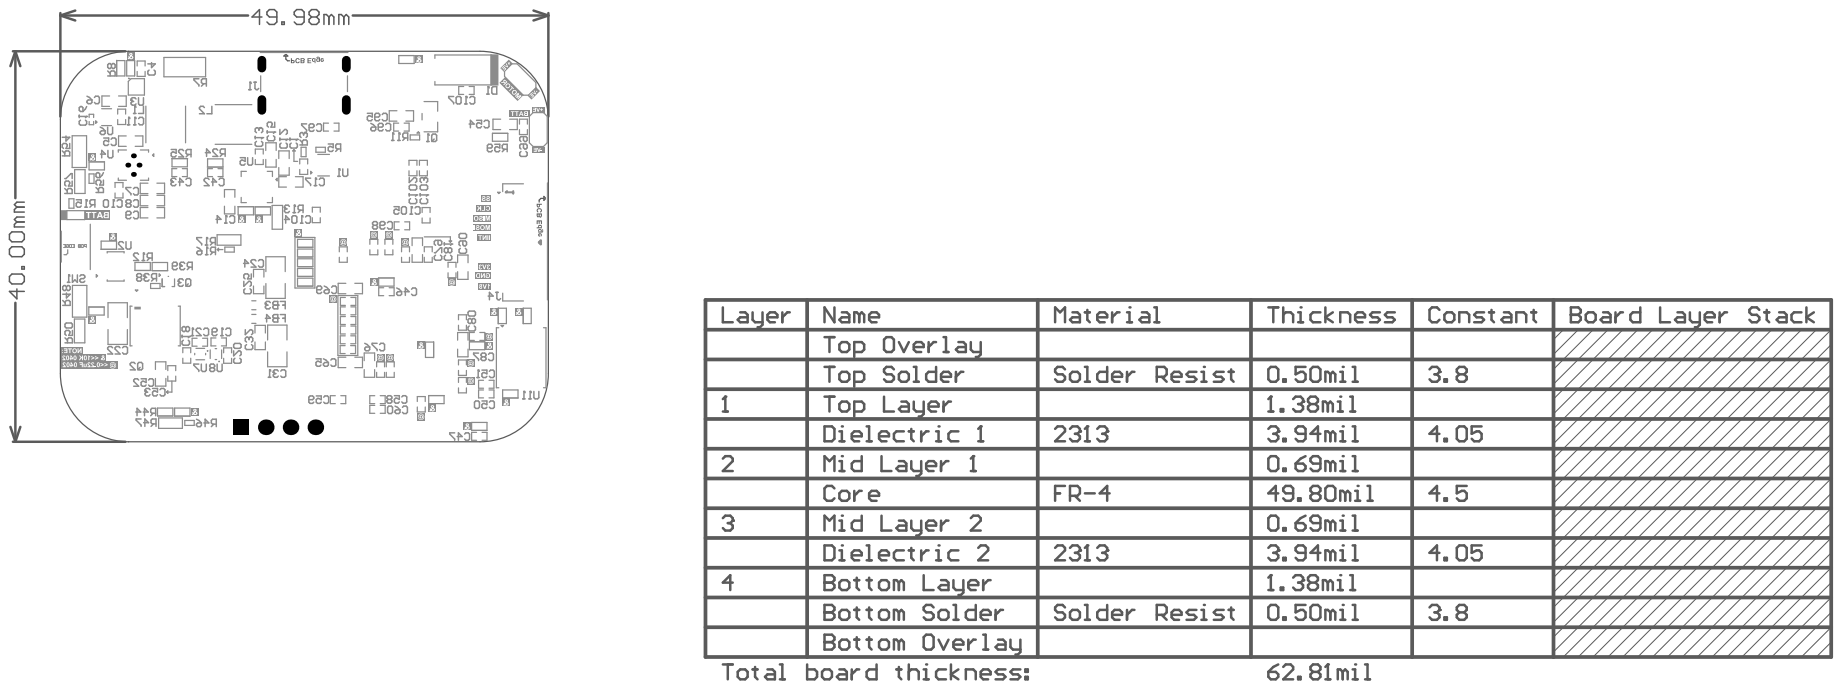
[picture p22: page 3]

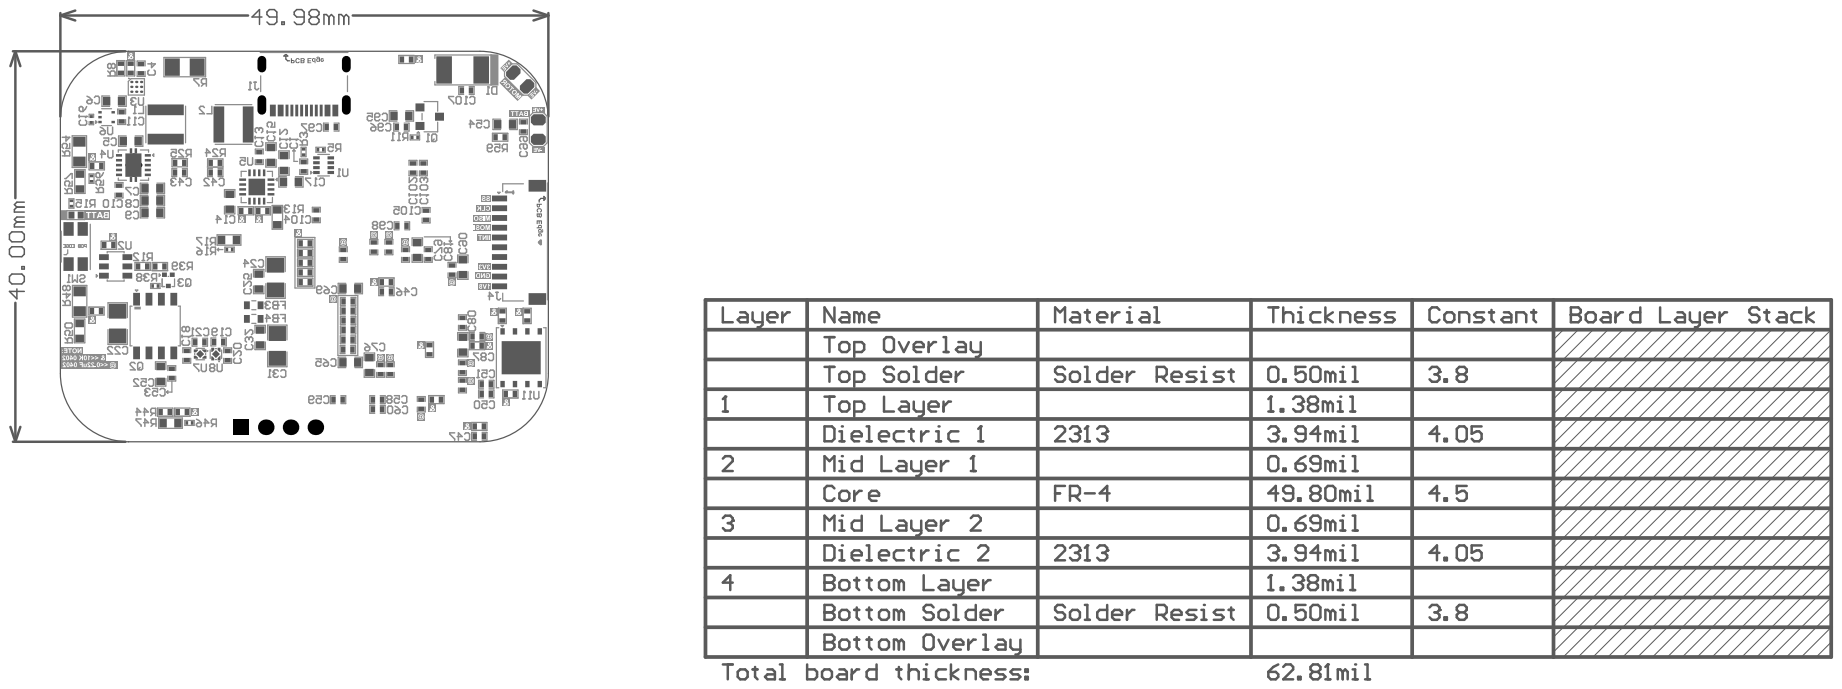
[picture p23: page 4]
