eSpark-Backup/griffin-radarsystem-hw/Design Files/SecondaryBoard_2.0/Schematic/Assembly Drawings.pdf

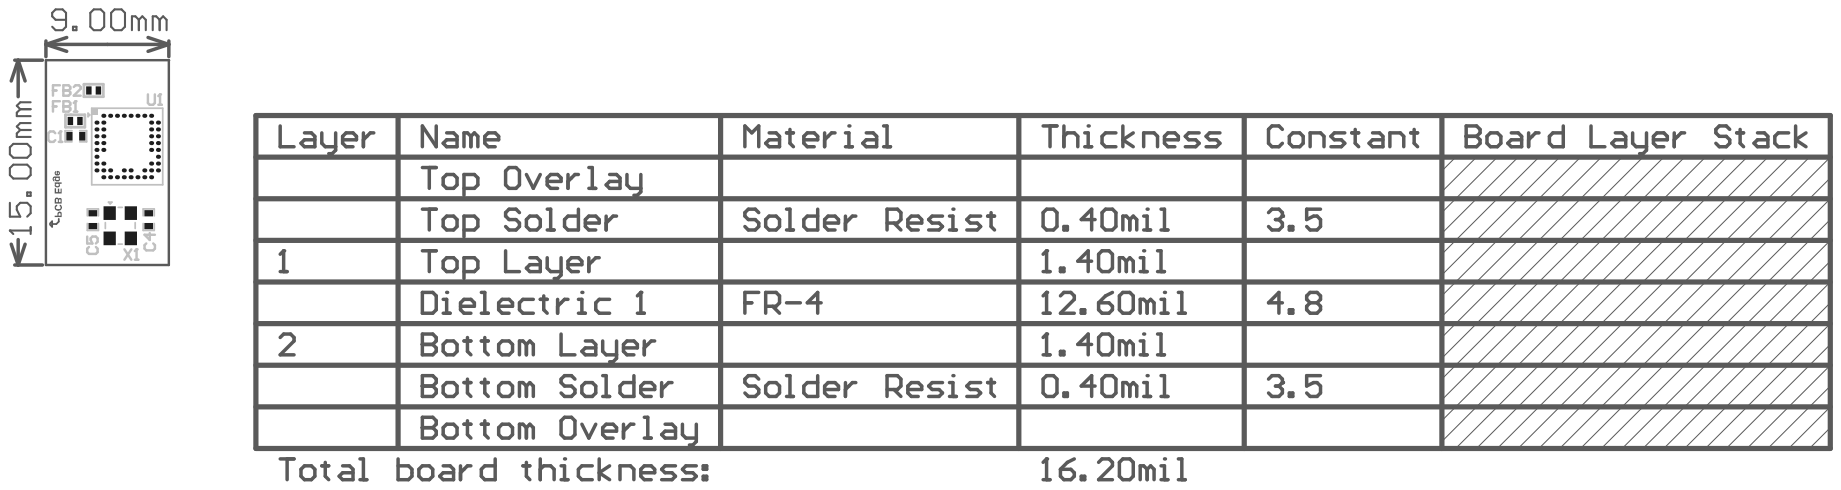
[picture p24: page 1]

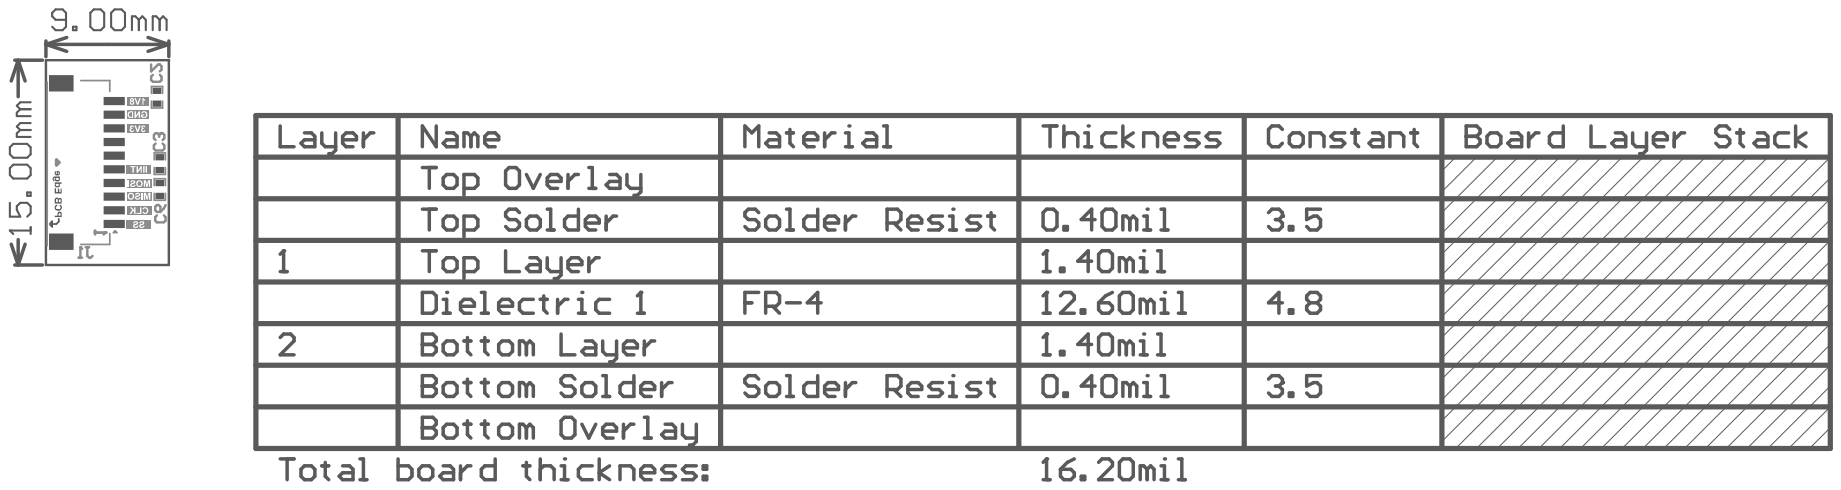
[picture p25: page 2]
