eSpark-Backup/griffin-radarsystem-hw/Design Files/SecondaryBoard_2.0/Schematic/Schematic_Secondary-Board_2.0.pdf

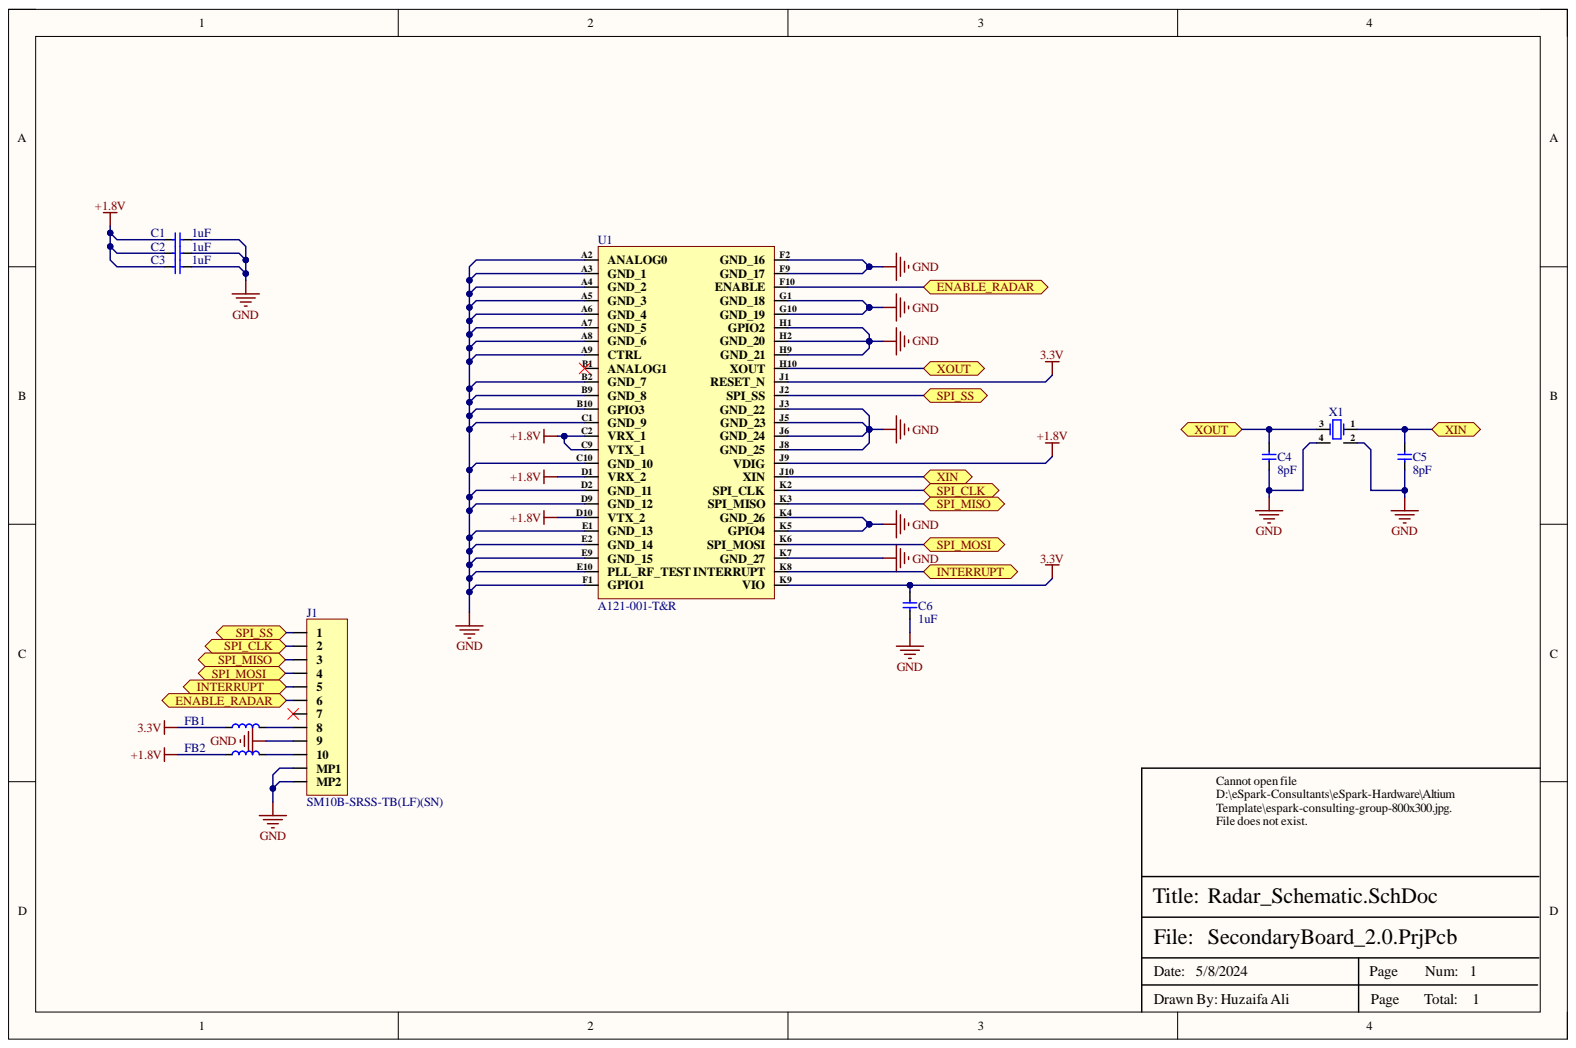
[picture p26: page 1]

Dat e : 5 / 8 / 2 0 2 4 | Pag e N u m : 11

D raw n B y : H uzai fa A l i | Pag e To t al :
