eSpark-Backup/griffin-radarsystem-hw/(list of files, drawings)

Other design files:
Design Files/MainBoard_2.0/Controller_Sheet.SchDoc
Design Files/MainBoard_2.0/Main_Board_2.0.PrjPcb
Design Files/MainBoard_2.0/PCB_Main_Board_v2.0.PcbDoc
Design Files/MainBoard_2.0/Radar_Power_Sheet.SchDoc
Design Files/MainBoard_2.0/Radar_Sheet1.SchDoc
Design Files/MainBoard_2.0/Radar_Sheet2.SchDoc
Design Files/MainBoard_2.0/System_Power_Sheet.SchDoc
Design Files/MainBoard_2.0/Top_Sheet.SchDoc
Design Files/Secondary Board/60ghz radar Sec...v1.1 pcb.PrjPcb
Design Files/SecondaryBoard_2.0/Radar_Schematic.SchDoc
Design Files/SecondaryBoard_2.0/SecondaryBoard_2.0.PcbDoc
Design Files/SecondaryBoard_2.0/SecondaryBoard_2.0.PrjPcb
docs/Client-Files/Src Files - v1.0/60ghz radar 2nd pcb/2nd pcb.PcbDoc
docs/Client-Files/Src Files - v1.0/60ghz radar 2nd pcb/60ghz radar 2nd pcb.PrjPcb
docs/Client-Files/Src Files - v1.0/60ghz radar 2nd pcb/radar schematic 2.SchDoc
docs/Client-Files/Src Files - v1.0/60ghz radar pcb/60ghz radar pcb.PcbDoc
docs/Client-Files/Src Files - v1.0/60ghz radar pcb/60ghz radar pcb.PrjPcb
docs/Client-Files/Src Files - v1.0/60ghz radar pcb/battery check and motor.SchDoc
docs/Client-Files/Src Files - v1.0/60ghz radar pcb/main sch.SchDoc
docs/Client-Files/Src Files - v1.0/60ghz radar pcb/power schematic.SchDoc
docs/Client-Files/Src Files - v1.0/60ghz radar pcb/radar sch.SchDoc
docs/Client-Files/Src Files - v1.0/60ghz radar pcb/SnapDocs/10144041-10011LF.PcbLib
docs/Client-Files/Src Files - v1.0/60ghz radar pcb/SnapDocs/10144041-10011LF.SchLib
docs/Client-Files/Src Files - v1.0/60ghz radar pcb/SnapDocs/ECS-80-12-33-JGN-TR.PcbLib
docs/Client-Files/Src Files - v1.0/60ghz radar pcb/SnapDocs/ECS-80-12-33-JGN-TR.SchLib
docs/Client-Files/Src Files - v1.0/60ghz radar pcb/SnapDocs/ECS-240-8-36-RWN-TR3.PcbLib
docs/Client-Files/Src Files - v1.0/60ghz radar pcb/SnapDocs/ECS-240-8-36-RWN-TR3.SchLib
docs/Client-Files/Src Files - v1.0/60ghz radar pcb/SnapDocs/ECS-.327-12.5-16-TR.PcbLib
docs/Client-Files/Src Files - v1.0/60ghz radar pcb/SnapDocs/ECS-.327-12.5-16-TR.SchLib
docs/Client-Files/Src Files - v1.0/60ghz radar pcb/SnapDocs/USB4120-03-C.PcbLib
docs/Client-Files/Src Files - v1.0/60ghz radar pcb/SnapDocs/USB4120-03-C.SchLib
