eSpark-Backup/griffin-radarsystem-hw/(commit log)

2024-03-29 client files pushed
    [10144041-10011LF.PcbLib, 10144041-10011LF.SchLib, 2nd pcb.PcbDoc, 60ghz radar 2nd pcb bom.csv, 60ghz radar 2nd pcb.PrjPcb, 60ghz radar pcb.PcbDoc, 60ghz radar pcb.PrjPcb, ECS-.327-12.5-16-TR.PcbLib]
2024-03-29 test commit
    [10144041-10011LF.PcbLib, 10144041-10011LF.SchLib, 2nd pcb.PcbDoc, 60ghz radar 2nd pcb bom.csv, 60ghz radar 2nd pcb.PrjPcb, 60ghz radar pcb.PcbDoc, 60ghz radar pcb.PrjPcb, ECS-.327-12.5-16-TR.PcbLib]
2024-03-29 #1 Secondary Board Schematic and Library added.
    [60ghz radar Sec...v1.1 pcb.PrjPcb, Sec... PCB_v1.1.PcbDoc, radar schematic 2.SchDoc]
2024-04-02 #1 Main PCB Board Schematic added.
    [60ghz radar main v1.1.PrjPcb, battery check and motor.SchDoc, main sch.SchDoc, power schematic.SchDoc, radar sch.SchDoc]
2024-04-08 #2 Schematic issues Corrected.
    [battery check and motor.SchDoc, main sch.SchDoc, power schematic.SchDoc]
2024-04-08 #3 Updated Files.
    [60ghz radar main v1.1.PrjPcb, 60ghz radar_v1.1.PcbDoc, battery check and motor.SchDoc, main sch.SchDoc]
2024-04-09 #3 Routing in progress
    [60ghz radar_v1.1.PcbDoc, battery check and motor.SchDoc, main sch.SchDoc, power schematic.SchDoc]
2024-04-15 #3 Routing in progress.
    [60ghz radar_v1.1.PcbDoc]
2024-04-18 #4 Schematic in progress
    [Controller_Sheet.SchDoc, Main_Board_2.0.PrjPcb, Power_Sheet.SchDoc, Radar_Sheet1.SchDoc, Radar_Sheet2.SchDoc]
2024-04-22 #4 Schematic completed
    [Controller_Sheet.SchDoc, Main_Board_2.0.PrjPcb, Power_Sheet.SchDoc, Radar_Power_Sheet.SchDoc, Radar_Sheet1.SchDoc, Radar_Sheet2.SchDoc, Sheet1.SchDoc, System_Power_Sheet.SchDoc]
2024-04-22 Parts placement in PCB In-progress.
    [60ghz radar_v1.1.PcbDoc, Main_Board_2.0.PrjPcb, PCB_Main_Board_v2.0.PcbDoc]
2024-04-23 #4 USB to UART removed and STM32 replaced with 64LQFP
    [Controller_Sheet.SchDoc, Radar_Power_Sheet.SchDoc, Radar_Sheet1.SchDoc, System_Power_Sheet.SchDoc, Top_Sheet.SchDoc]
2024-04-23 Placement in-progress.
    [PCB_Main_Board_v2.0.PcbDoc, System_Power_Sheet.SchDoc]
2024-04-24 #4 Power Switch added
    [Controller_Sheet.SchDoc, System_Power_Sheet.SchDoc]
2024-04-24 #4 R7 reduced to 1206 package
    [Controller_Sheet.SchDoc, System_Power_Sheet.SchDoc]
2024-04-24 #4 Netlabel corrected and LED2 package changed
    [Radar_Power_Sheet.SchDoc, System_Power_Sheet.SchDoc]
2024-04-24 #7 Placement in Progress
    [Main_Board_2.0.PrjPcb, PCB_Main_Board_v2.0.PcbDoc]
2024-04-24 #4 JTAG connector replaced
    [Radar_Sheet1.SchDoc]
2024-04-24 #6 Updated BOM.
    [Client-BOM-Main_Board_2.0.xlsx, eSpark-BOM_Main_Board_2.0.xlsx]
2024-04-25 #4 USB connector J1 and Secondary Board connector J4 replaced
    [Controller_Sheet.SchDoc, System_Power_Sheet.SchDoc]
2024-04-25 #4 Secondary PCB connector J1 replaced
    [60ghz radar main v1.1.PrjPcb, 60ghz radar_v1.1.PcbDoc, Radar_Schematic.SchDoc, Sec... PCB_v1.1.PcbDoc, SecondaryBoard_2.0.PrjPcb, battery check and motor.SchDoc, main sch.SchDoc, power schematic.SchDoc]
2024-04-25 #4 GND added in schematic
    [System_Power_Sheet.SchDoc]
2024-04-25 #7 Parts placement in Progress
    [Main_Board_2.0.PrjPcb, PCB_Main_Board_v2.0.PcbDoc, System_Power_Sheet.SchDoc]
2024-04-26 #6 Updated BOM with Peripheral acc. to current Schematic.
    [Client-BOM-Main_Board_2.0.xlsx, eSpark-BOM_Main_Board_2.0.xlsx]
2024-04-29 #7 Placement completed, components re-added due footprint missing issue and net label corrected
    [Controller_Sheet.SchDoc, PCB_Main_Board_v2.0.PcbDoc, Radar_Sheet2.SchDoc, System_Power_Sheet.SchDoc]
2024-04-29 #5 Changes done and fresh PDF generated
    [Controller_Sheet.SchDoc, Radar_Sheet1.SchDoc, System_Power_Sheet.SchDoc]
2024-04-29 #4 Test points added
    [Radar_Sheet1.SchDoc]
2024-04-29 #6 Client and eSpark BOM changes update
    [Client-BOM-Main_Board_2.0.xlsx, eSpark-BOM_Main_Board_2.0.xlsx]
2024-04-30 #4 Ferrite bead added in Secondary Board
    [Radar_Schematic.SchDoc]
2024-04-30 #7 Formatting completed routing in Progress
    [PCB_Main_Board_v2.0.PcbDoc]
2024-05-02 #7 Routing in progress
    [PCB_Main_Board_v2.0.PcbDoc]
2024-05-07 #7 main board completed review remaining
    [Main_Board_2.0.PrjPcb, PCB_Main_Board_v2.0.PcbDoc, Sec... PCB_v1.1.PcbDoc, SecondaryBoard_2.0.PrjPcb]
2024-05-08 #7 both pcbs completed
    [2nd pcb.DXF, 2nd pcb.PcbDoc, PCB_Main_Board_v2.0.PcbDoc, Radar_Schematic.SchDoc, Sec... PCB_v1.1.PcbDoc, SecondaryBoard_2.0.PcbDoc, SecondaryBoard_2.0.PrjPcb]
2024-05-08 #7 Changes done in Main board
    [PCB_Main_Board_v2.0.PcbDoc]
2024-05-08 #7 Secondary pcb overlay updated
    [SecondaryBoard_2.0.PcbDoc]
2024-05-08 #6 Cable update in Main PCB BOM and generated sec PCB altium BOM.
    [Client-BOM-Main_Board_2.0.xlsx, Client_BOM_SecondaryBoard_2.0.xlsx, eSpark-BOM_Main_Board_2.0.xlsx]
2024-05-08 #7 Deliverables of Secondary Board Generated.
    [Centroid_File-SecondaryBoard_2.0.csv, Pick Place for SecondaryBoard_2.0.csv, SecondaryBoard_2.0.DWG, SecondaryBoard_2.0.DXF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]
2024-05-08 #7 Deliverables of Main Baorad-v2.0 Generated.
    [Centroid_File-Main_Board_v2.0.csv, Client-BOM-Main_Board_2.0.xlsx, Controller_Sheet.SchDoc, Main_Board_2.0.PrjPcb, PCB_Main_Board_v2.0.DWG, PCB_Main_Board_v2.0.DXF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]
2024-05-14 #8 Board Outline and gerber Files Created.
    [Main_Board_2.0.PrjPcb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]
